ElJoho/BerkikRe-Design/analysis/avl/summary_drag.md

| Model | CD at 12 m/s: profile + winglets + induced + base = total | L/D at 12 m/s | Best L/D (at m/s) | Min. power for level flight [W] |
|---|---|---|---|---|
| Base | 0.0128 + 0.0004 + 0.0048 + 0.0020 = **0.0201** | 10.9 | 14.7 (8) | 3.7 |
| CW | 0.0121 + 0.0003 + 0.0048 + 0.0020 = **0.0192** | 11.3 | 14.8 (8) | 3.7 |
| CC | 0.0126 + 0.0004 + 0.0040 + 0.0020 = **0.0189** | 11.3 | 14.9 (8) | 3.7 |
| CC+CW | 0.0126 + 0.0003 + 0.0039 + 0.0020 = **0.0189** | 11.3 | 15.0 (8) | 3.7 |
| CC+RT | 0.0126 + 0.0004 + 0.0040 + 0.0007 = **0.0177** | 12.1 | 15.5 (8) | 3.5 |
| CC+RT+CW | 0.0126 + 0.0003 + 0.0040 + 0.0007 = **0.0177** | 12.1 | 15.6 (8) | 3.5 |
| RT | 0.0124 + 0.0004 + 0.0048 + 0.0007 = **0.0184** | 11.9 | 15.4 (8) | 3.6 |
| RT+CW | 0.0118 + 0.0003 + 0.0048 + 0.0007 = **0.0176** | 12.4 | 15.6 (8) | 3.5 |
| contourn | 0.0124 + 0.0005 + 0.0049 + 0.0021 = **0.0198** | 10.9 | 14.9 (8) | 3.7 |

Strip cl outside a polar's range (clamped): {'Base': 0, 'CW': 54, 'CC': 36, 'CC+CW': 36, 'CC+RT': 36, 'CC+RT+CW': 16, 'RT': 108, 'RT+CW': 96, 'contourn': 568}
