ElJoho/BerkikRe-Design/analysis/figures/views_front.png

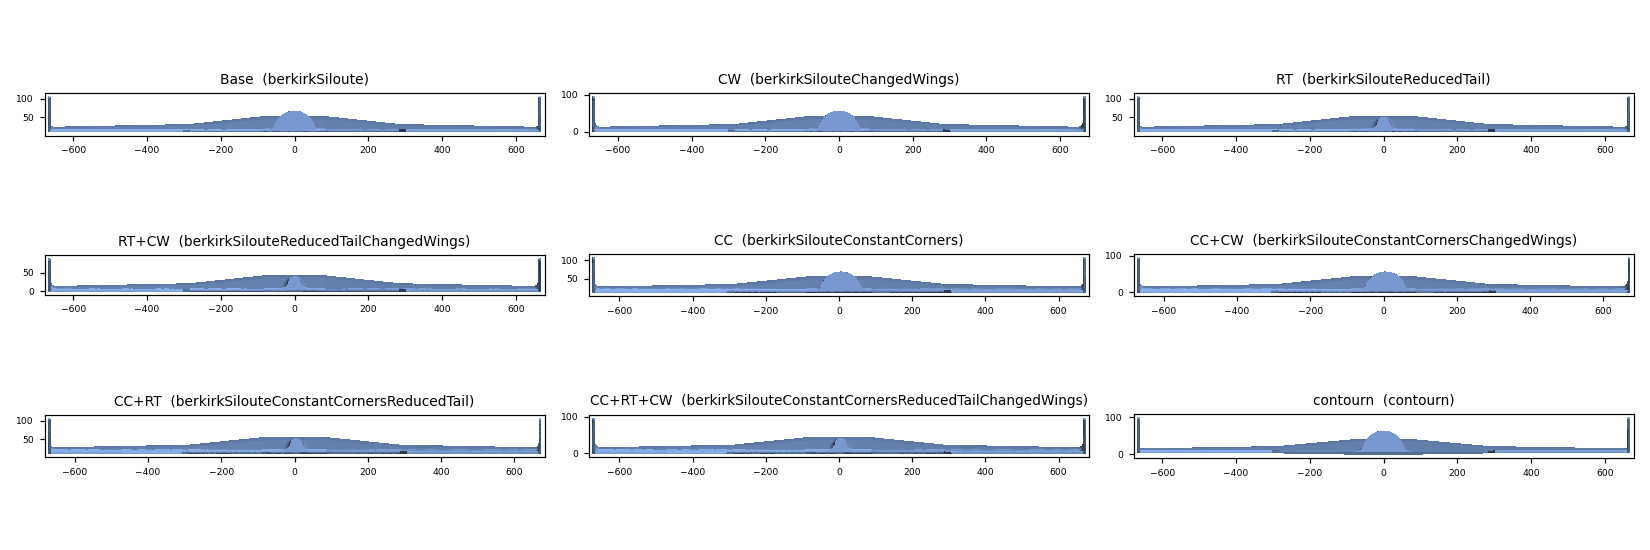
analysis/figures/views_front.png
