ElJoho/BerkikRe-Design/berkik_layout.png

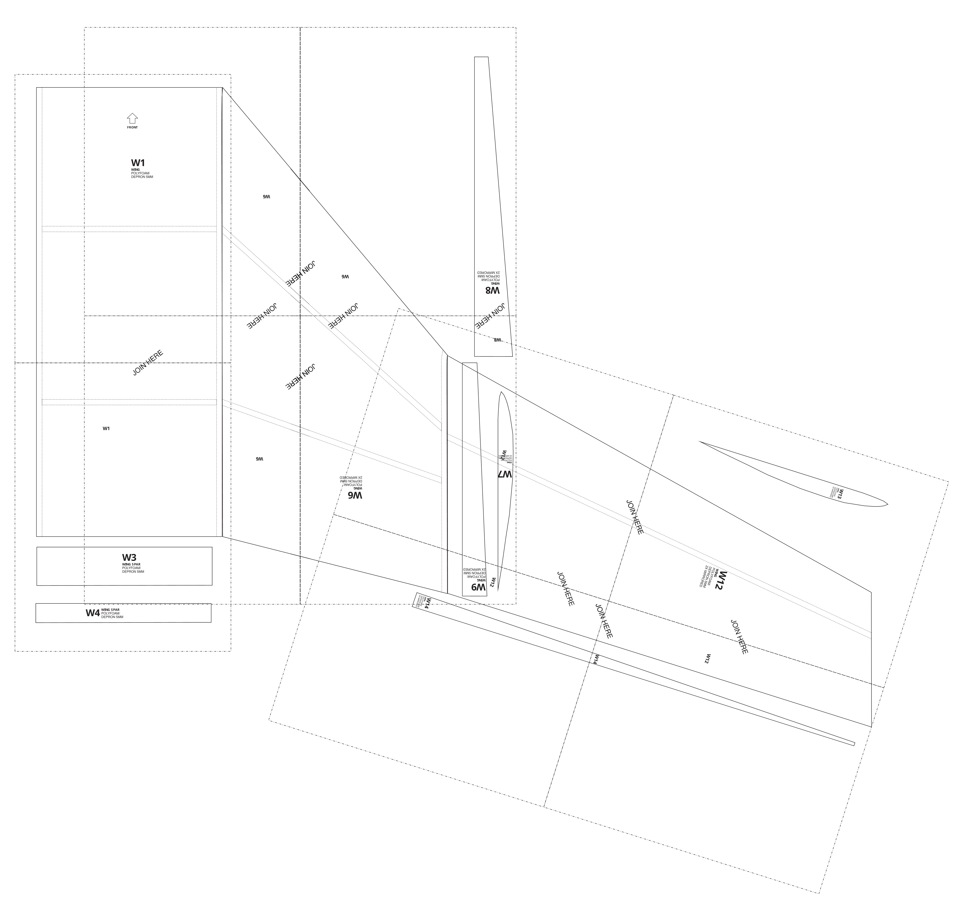
berkik_layout.png
