ElJoho/BerkikRe-Design/berkik_w2_w5_m1_m2_m3.png

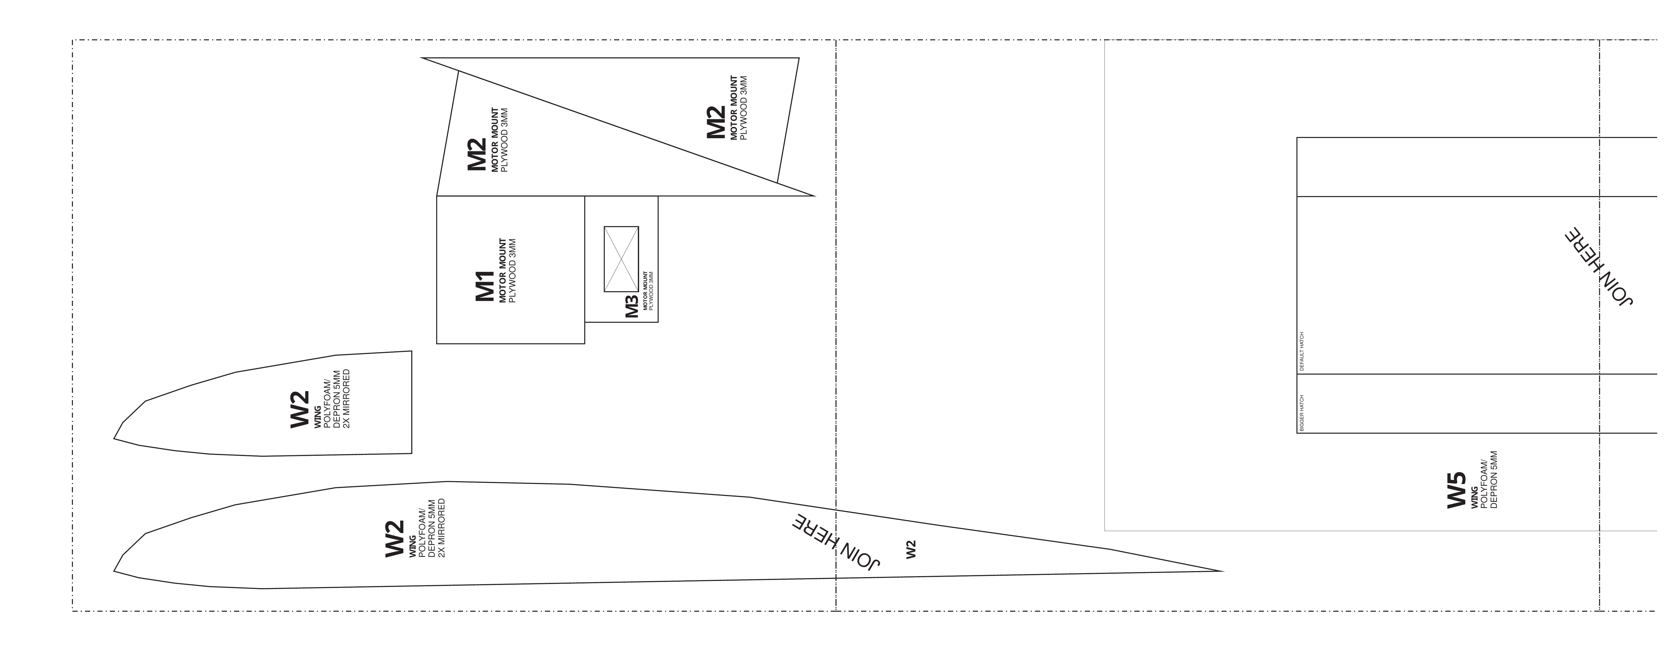
berkik_w2_w5_m1_m2_m3.png
