ElJoho/BerkikRe-Design/img/berkik_w15_w16_w17_w18_t1.png

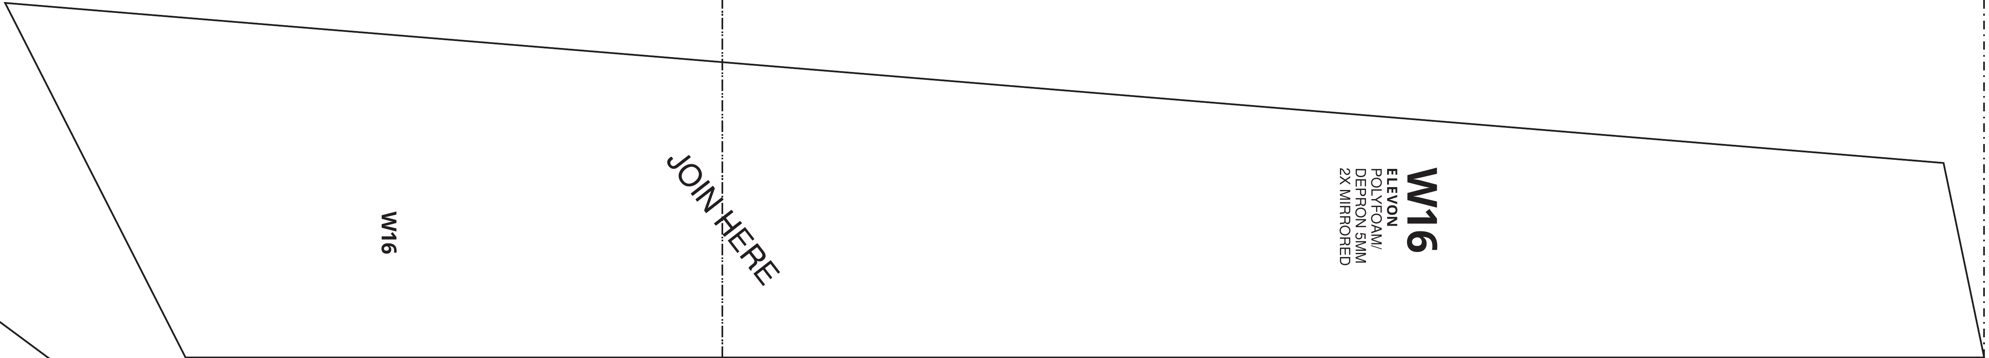
img/berkik_w15_w16_w17_w18_t1.png
