ElJoho/BerkikRe-Design/img/M1.png

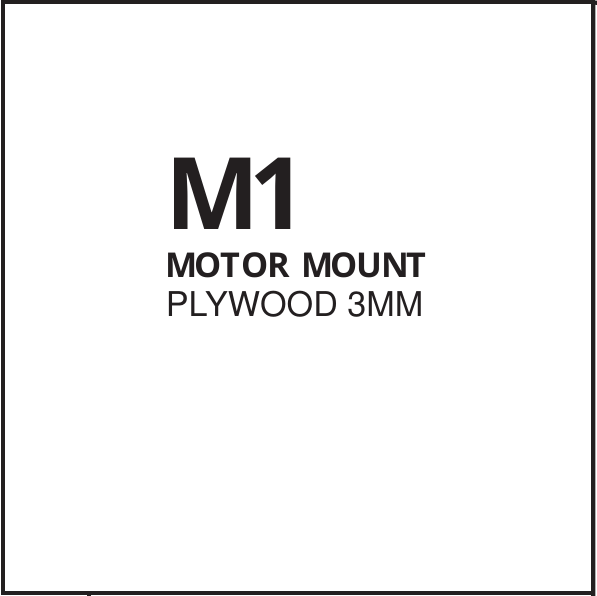
img/M1.png
