ElJoho/BerkikRe-Design/img/pagina-01.png

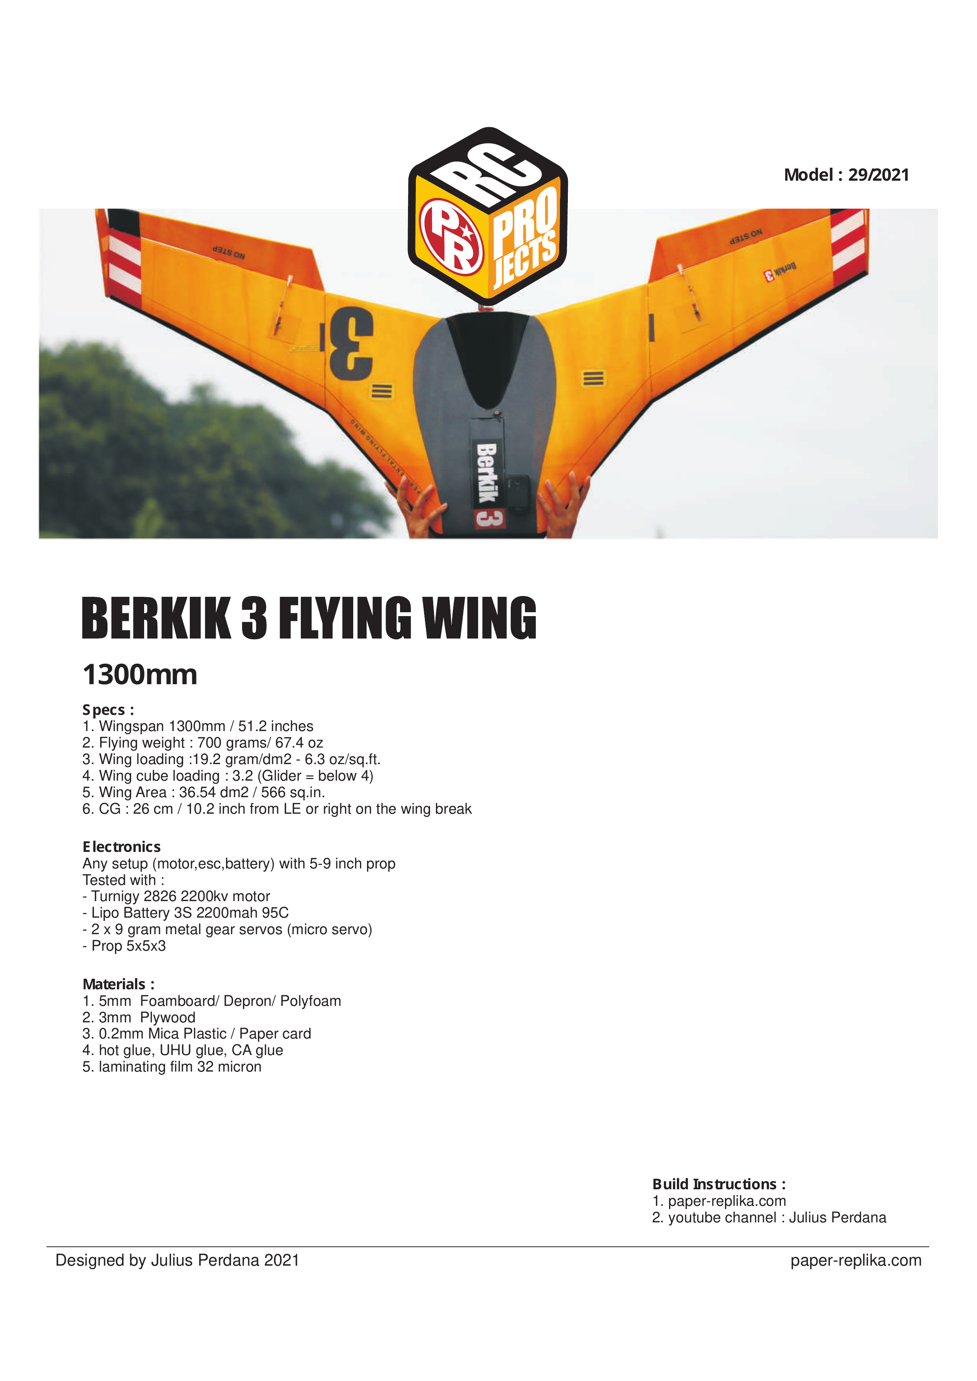
img/pagina-01.png
