ElJoho/BerkikRe-Design/img/pagina-02.png

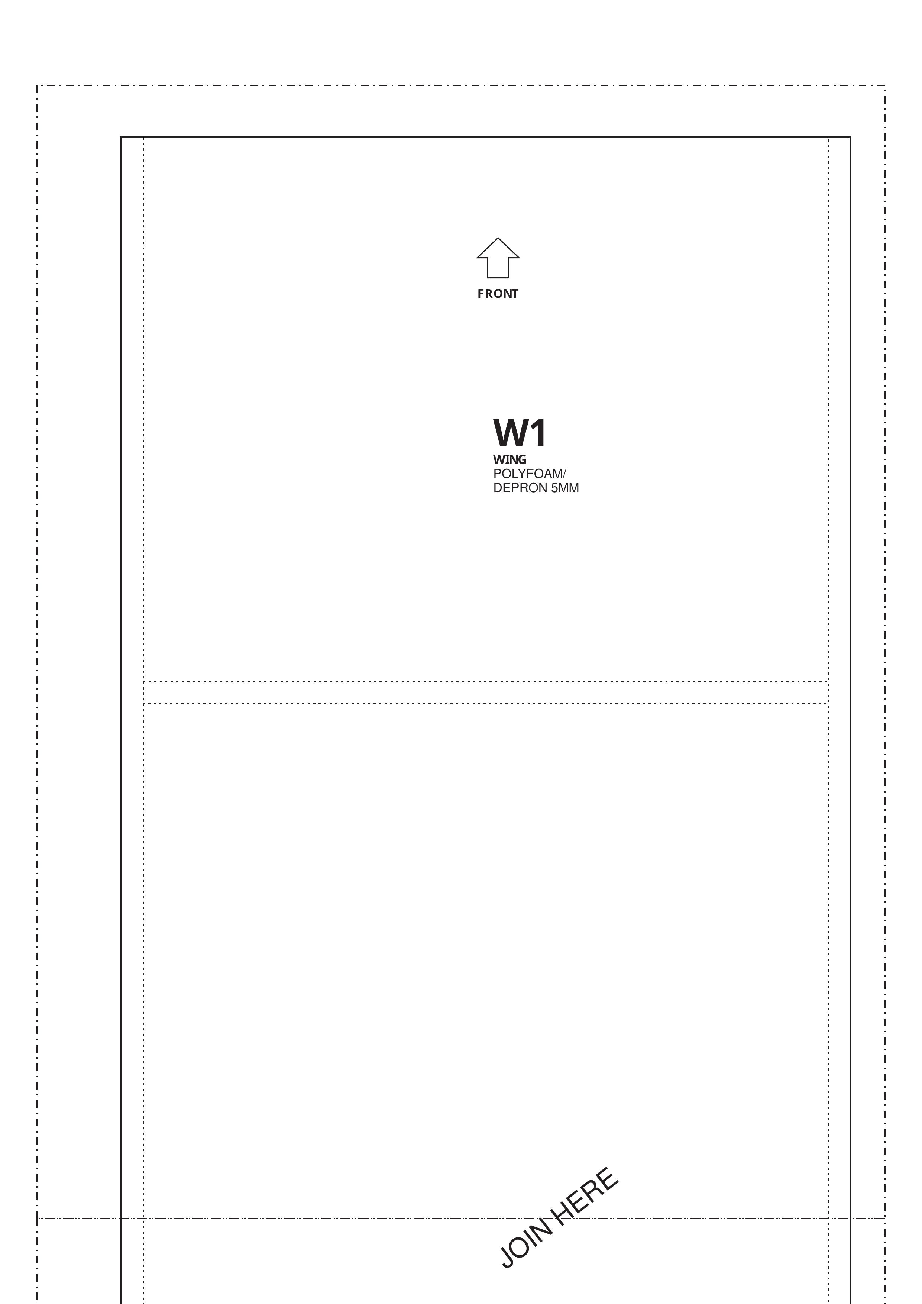
img/pagina-02.png
