ElJoho/BerkikRe-Design/img/pagina-03.png

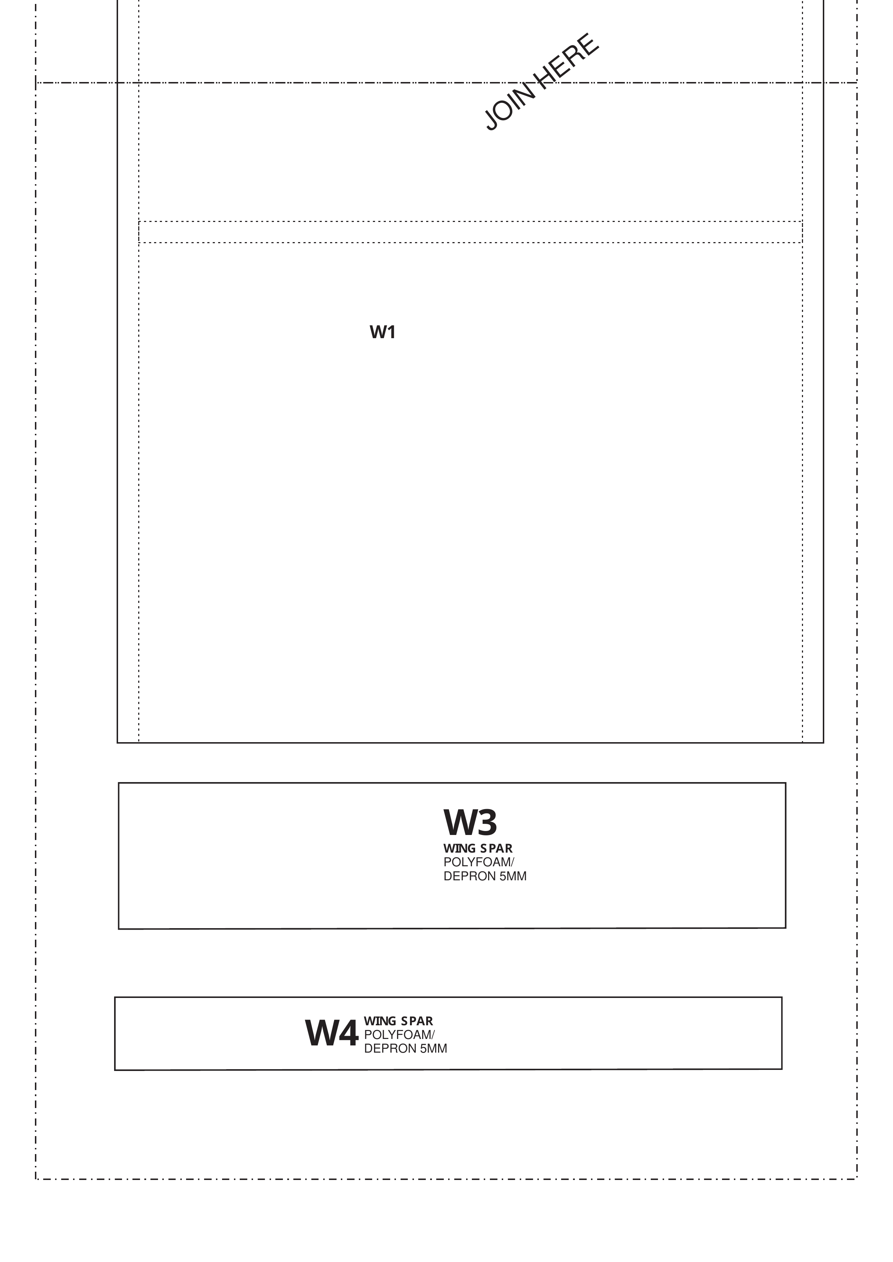
img/pagina-03.png
