ElJoho/BerkikRe-Design/img/pagina-04.png

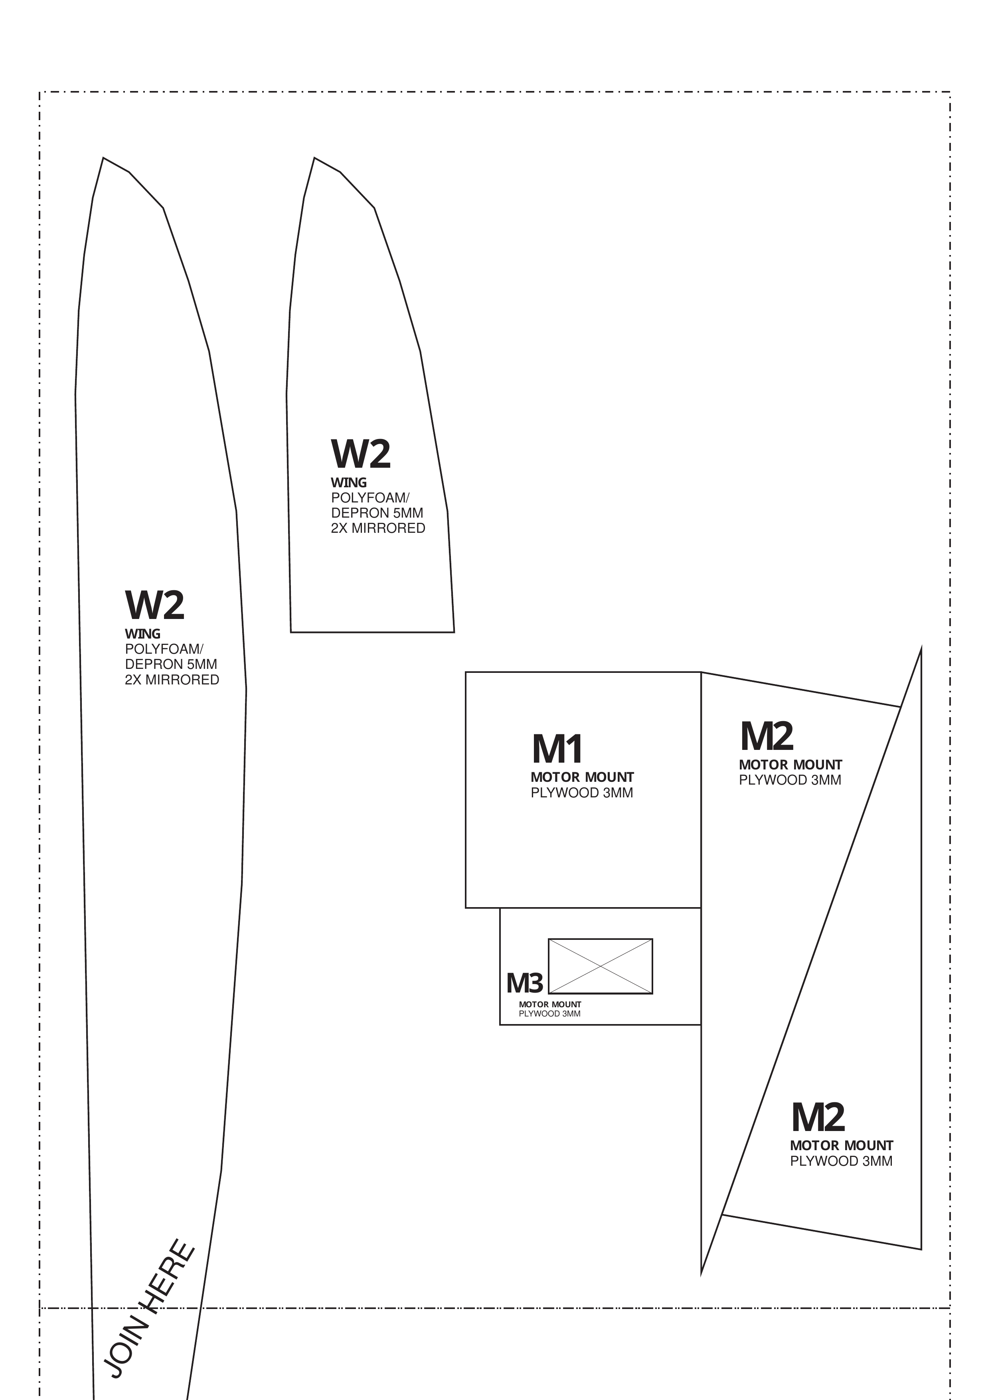
img/pagina-04.png
