ElJoho/BerkikRe-Design/img/pagina-05.png

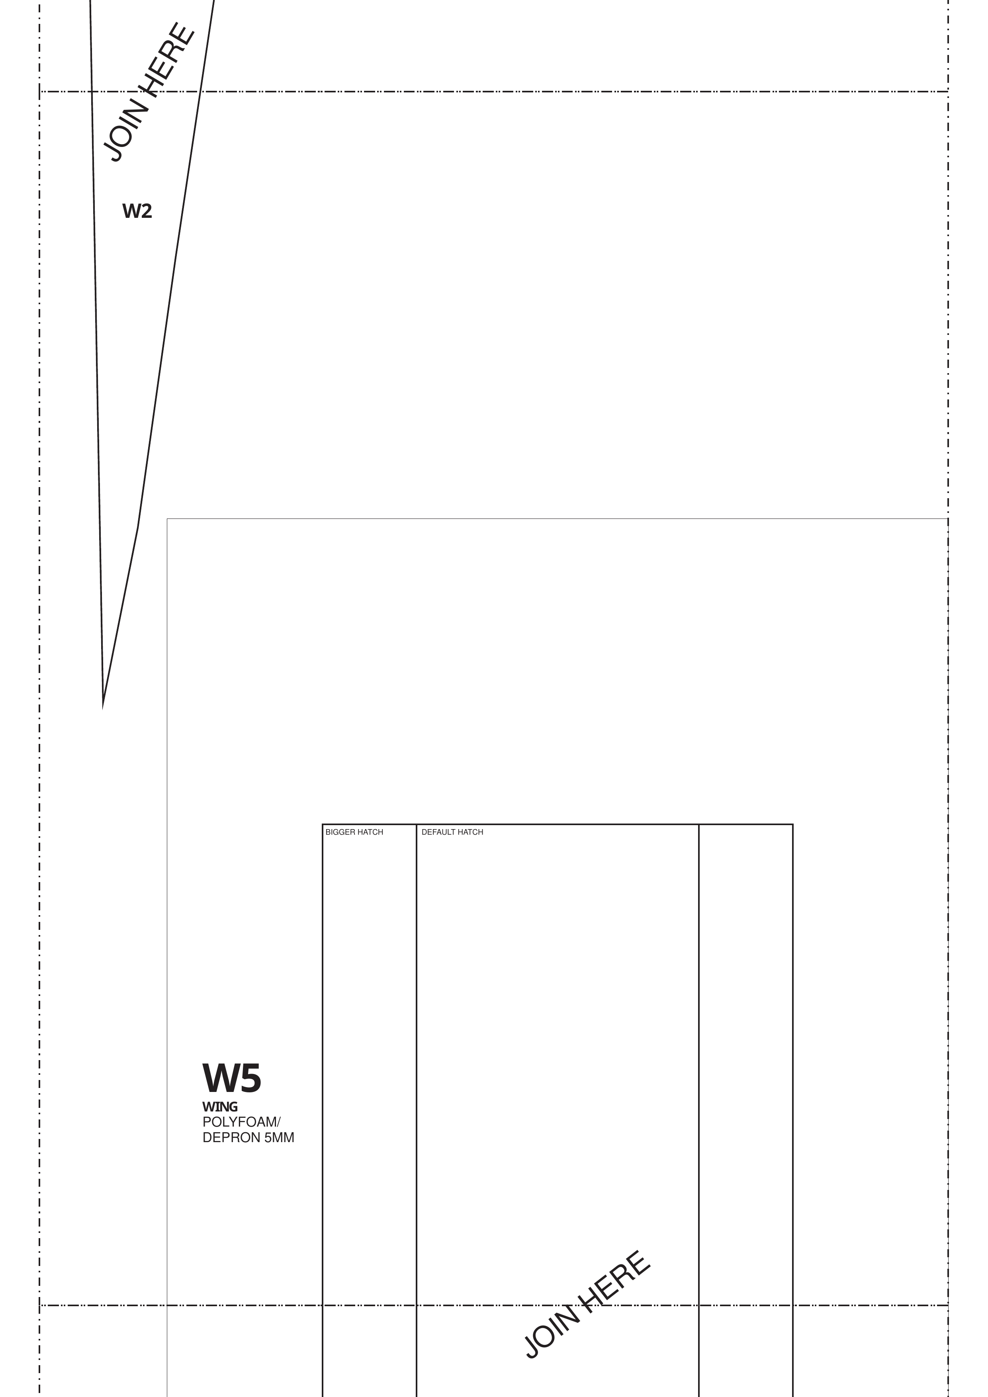
img/pagina-05.png
