ElJoho/BerkikRe-Design/img/pagina-06.png

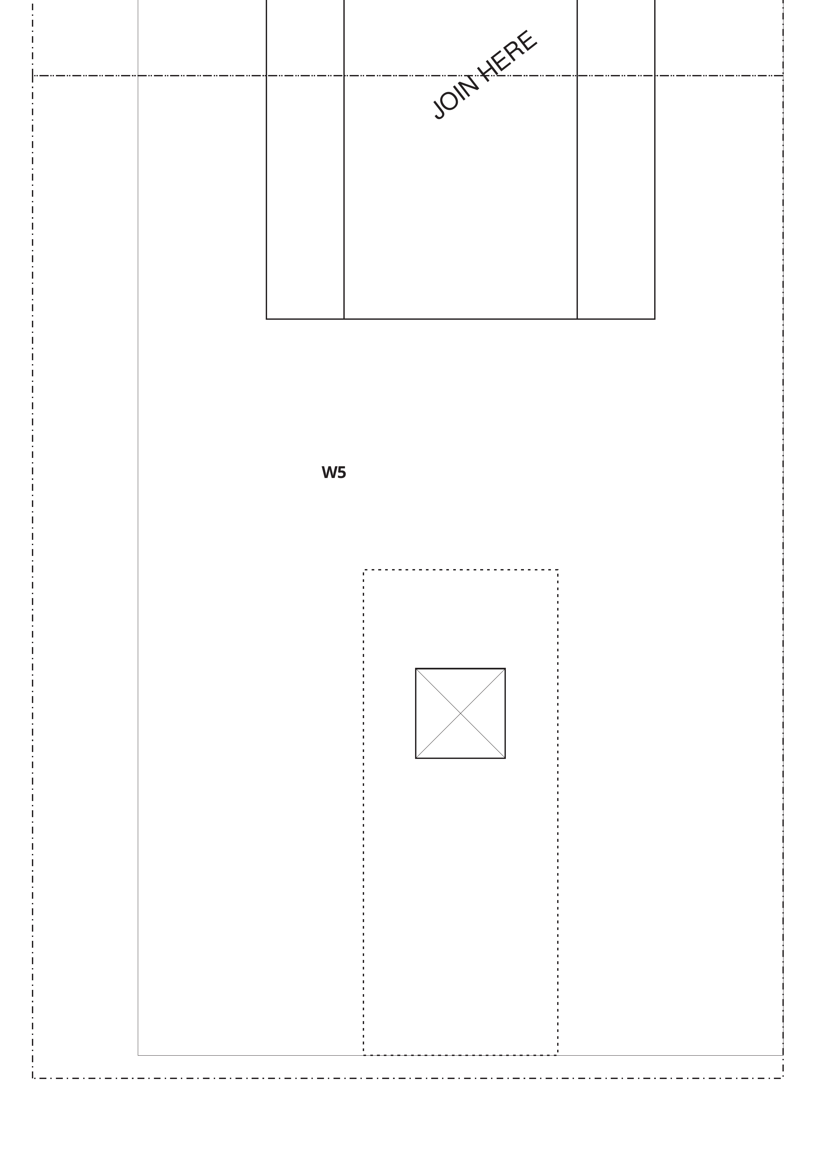
img/pagina-06.png
