ElJoho/BerkikRe-Design/img/pagina-07.png

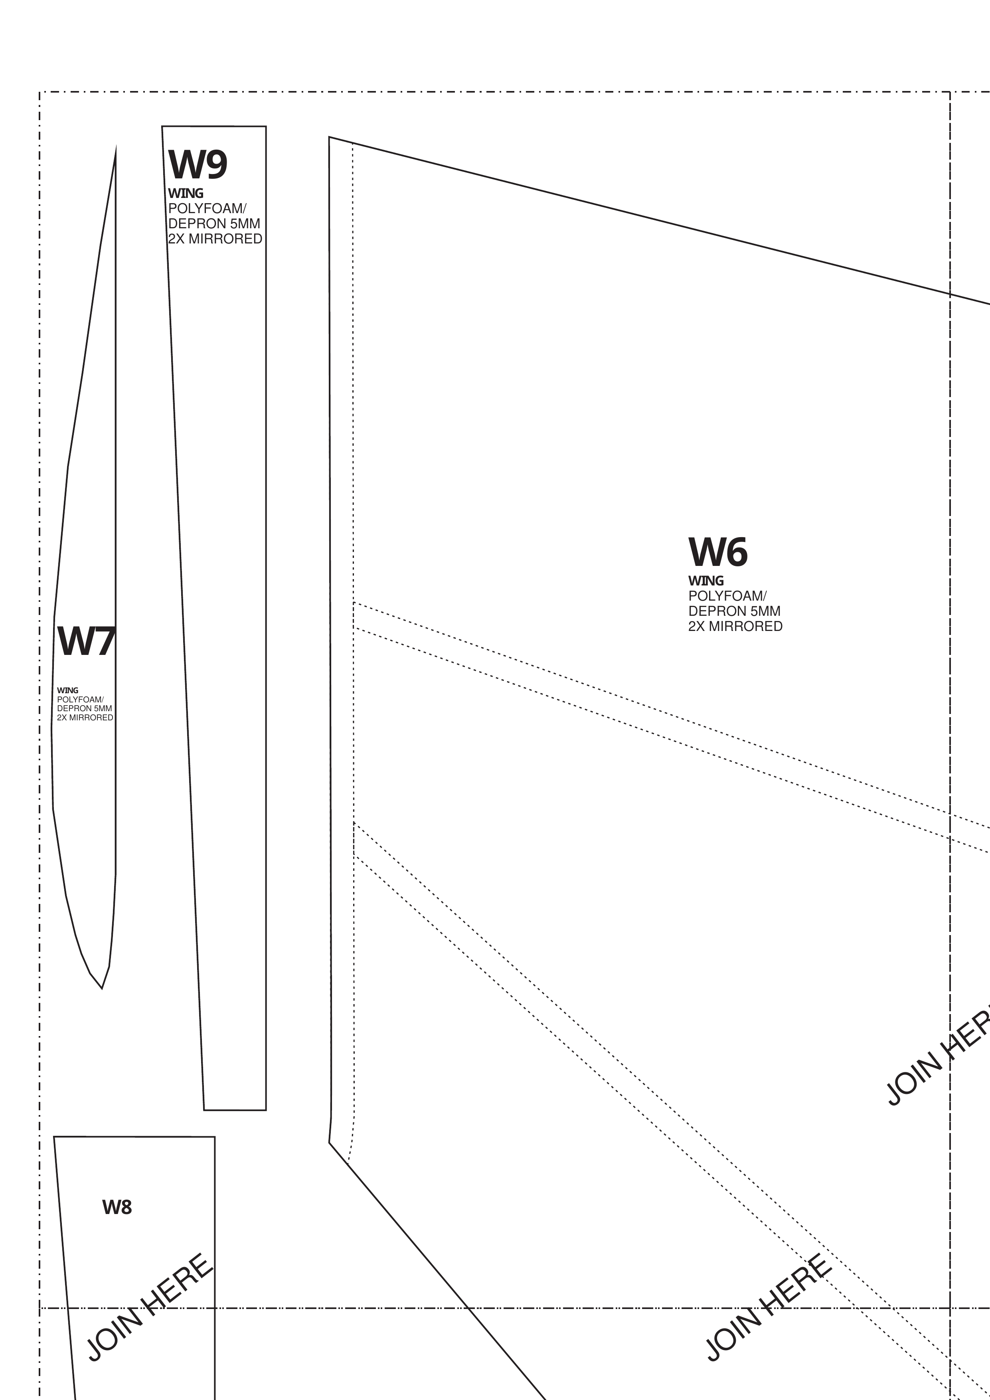
img/pagina-07.png
