ElJoho/BerkikRe-Design/img/pagina-08.png

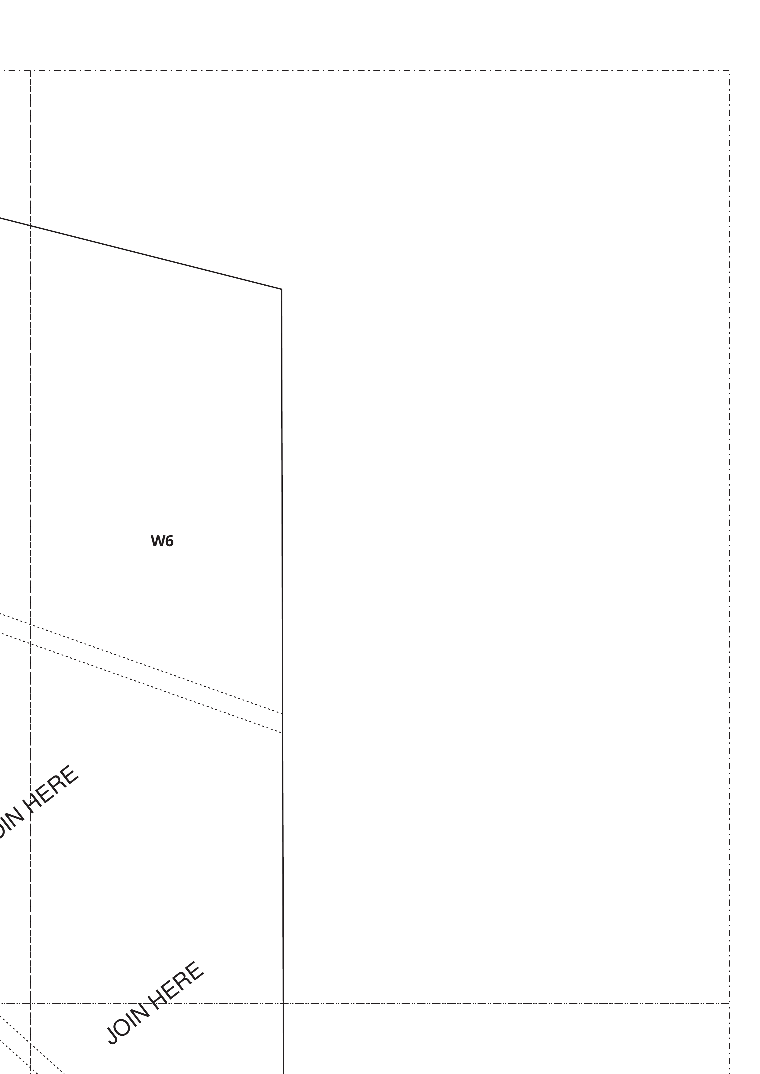
img/pagina-08.png
