ElJoho/BerkikRe-Design/img/pagina-09.png

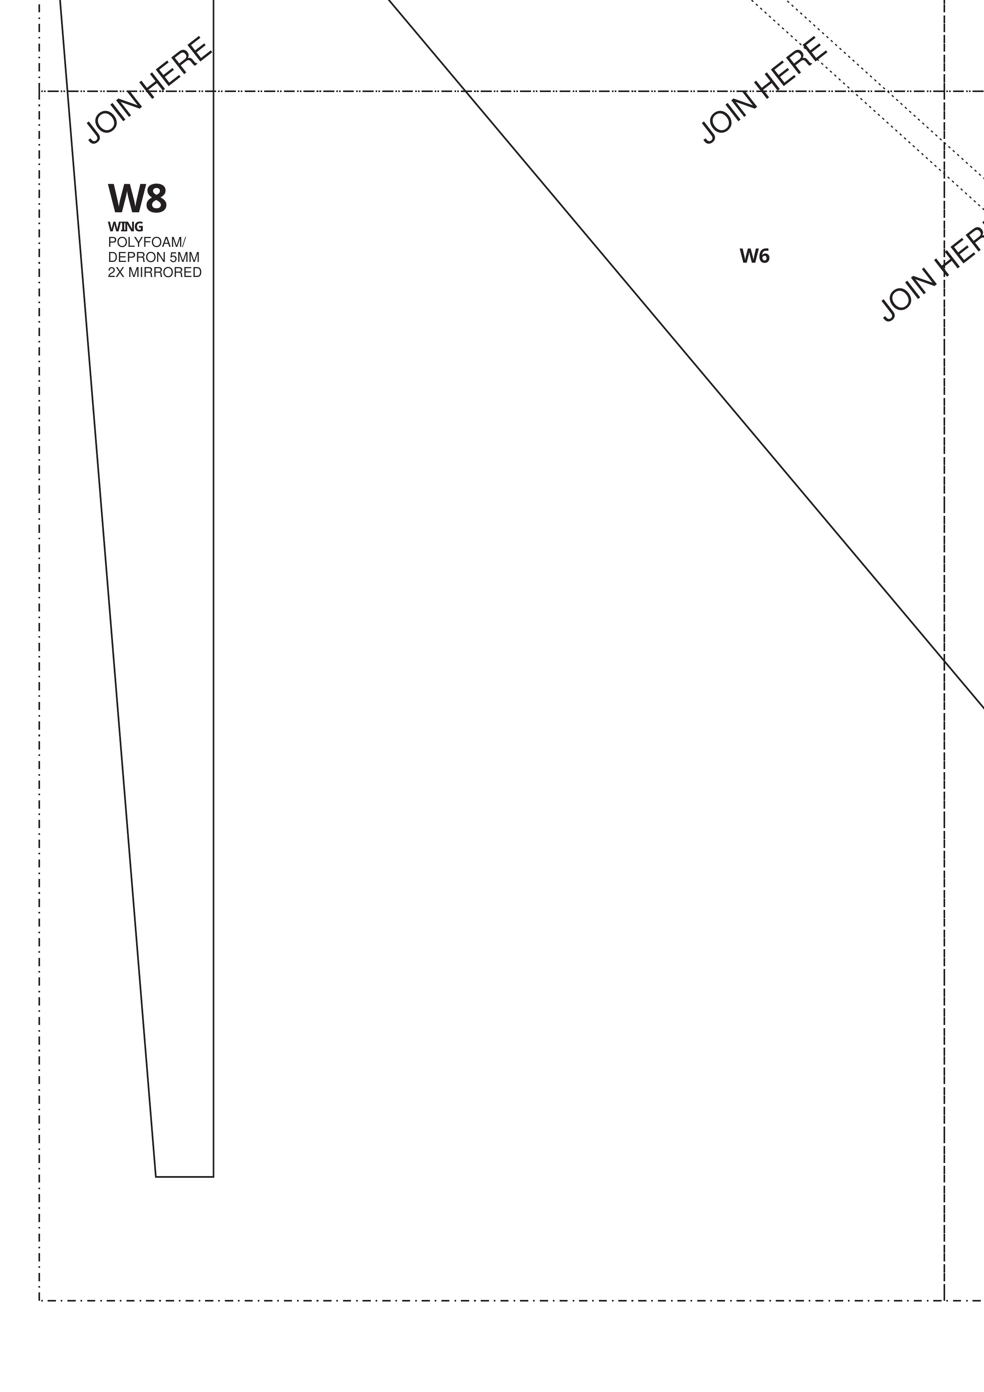
img/pagina-09.png
