ElJoho/BerkikRe-Design/img/pagina-10.png

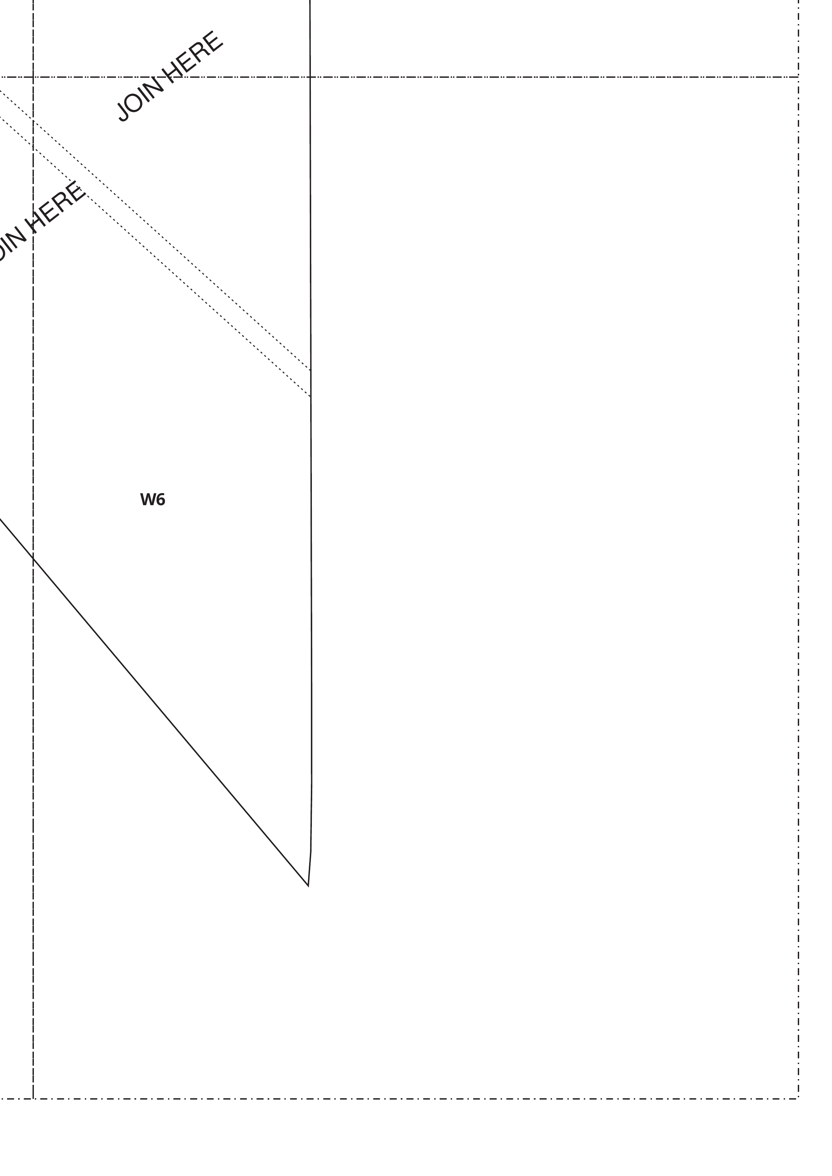
img/pagina-10.png
