ElJoho/BerkikRe-Design/img/pagina-11.png

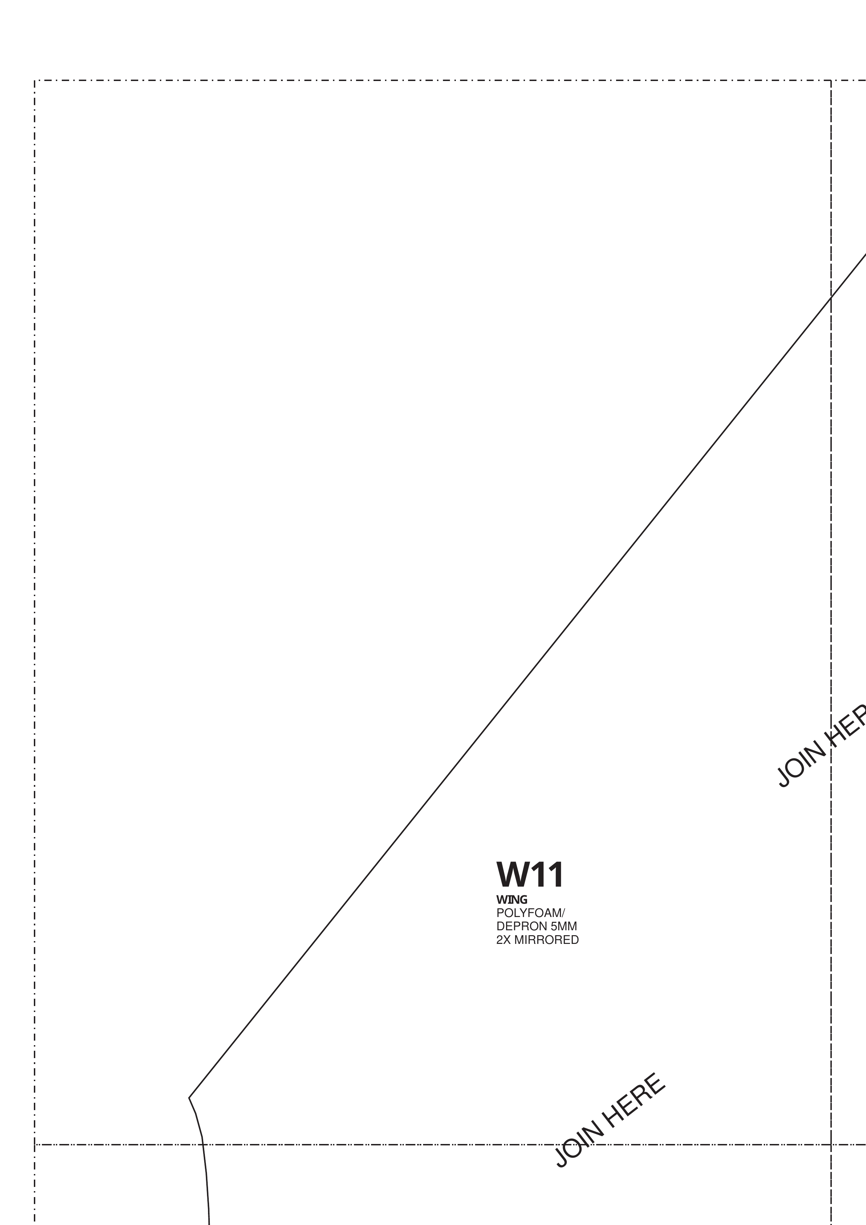
img/pagina-11.png
