ElJoho/BerkikRe-Design/img/pagina-12.png

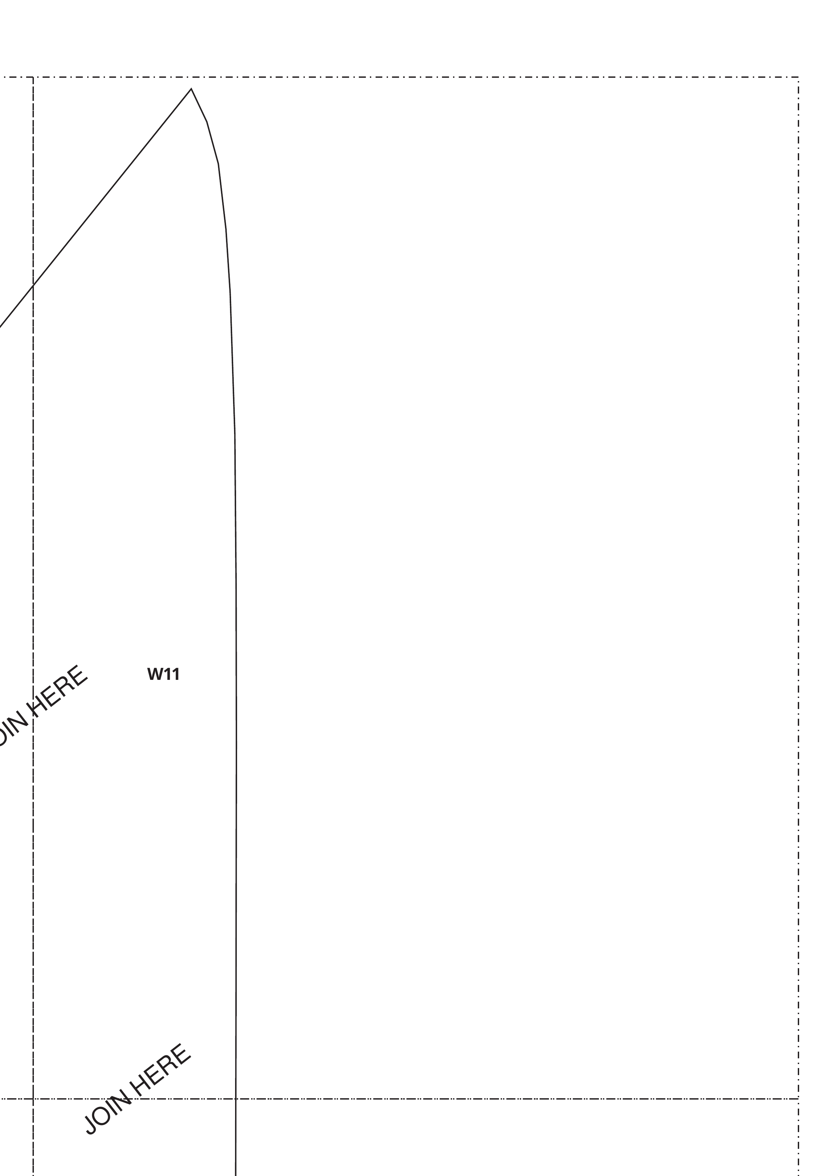
img/pagina-12.png
