ElJoho/BerkikRe-Design/img/pagina-13.png

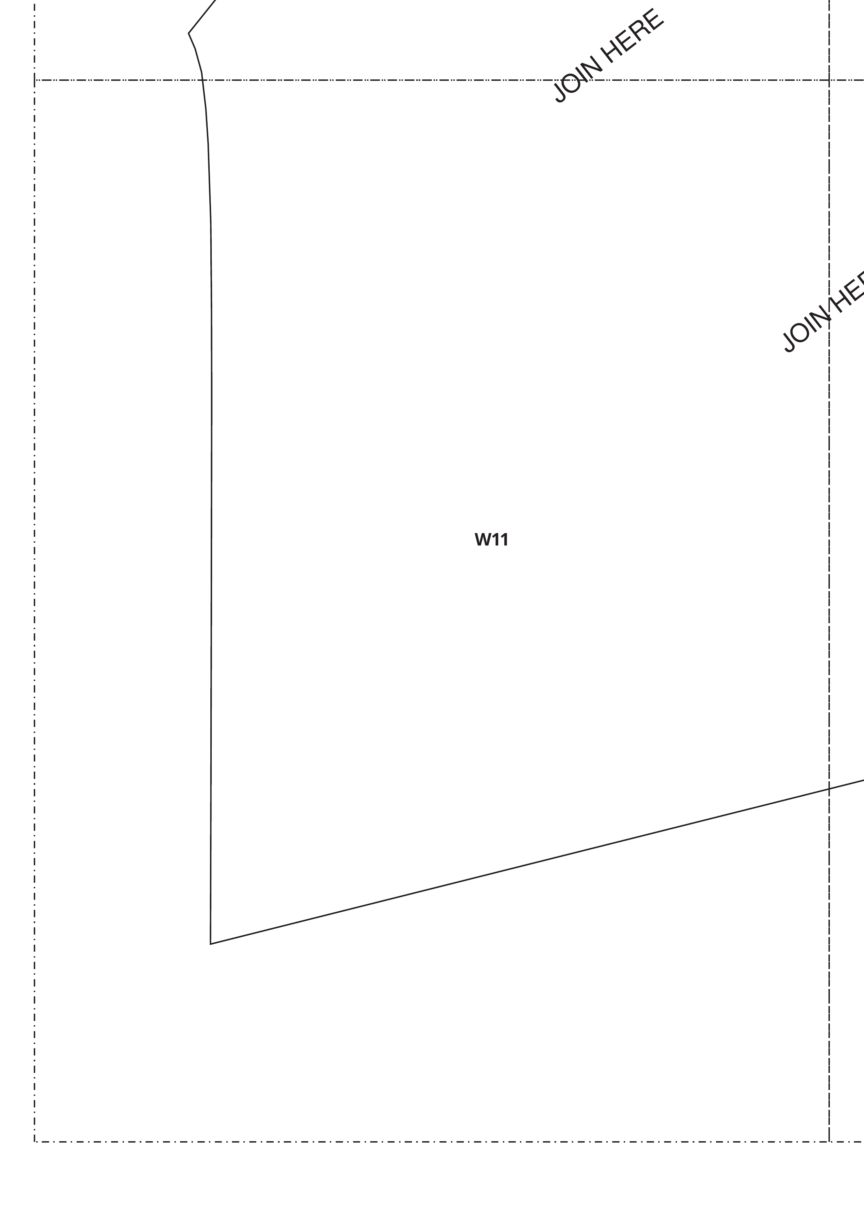
img/pagina-13.png
