ElJoho/BerkikRe-Design/img/pagina-14.png

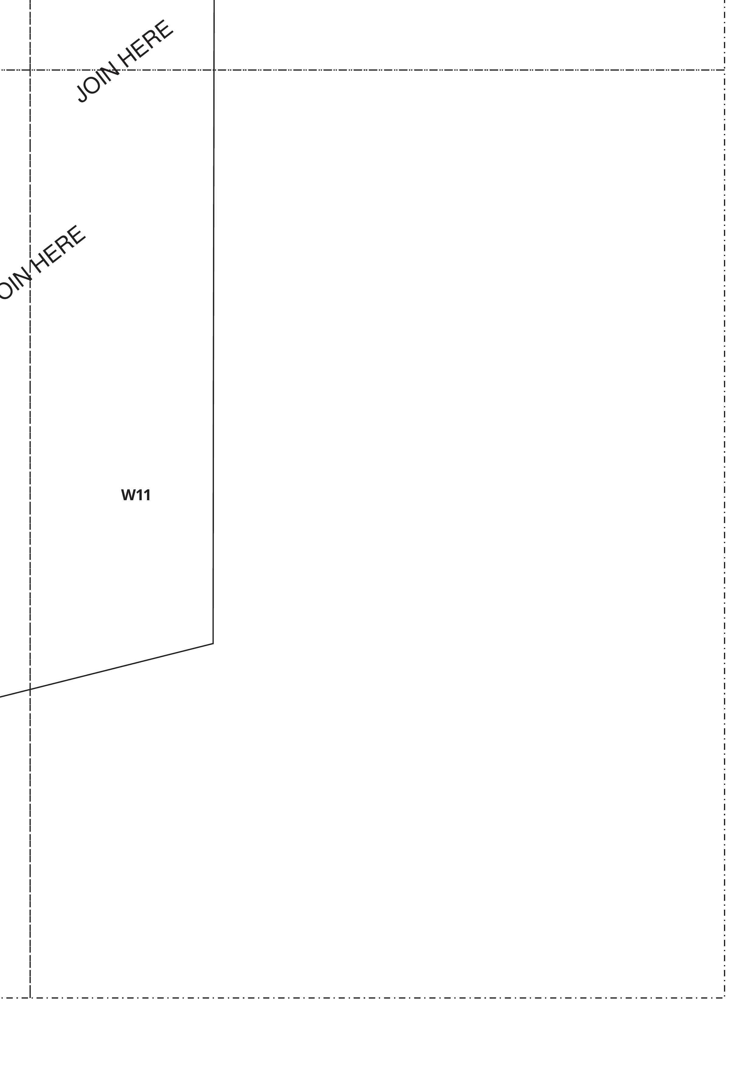
img/pagina-14.png
