ElJoho/BerkikRe-Design/img/pagina-15.png

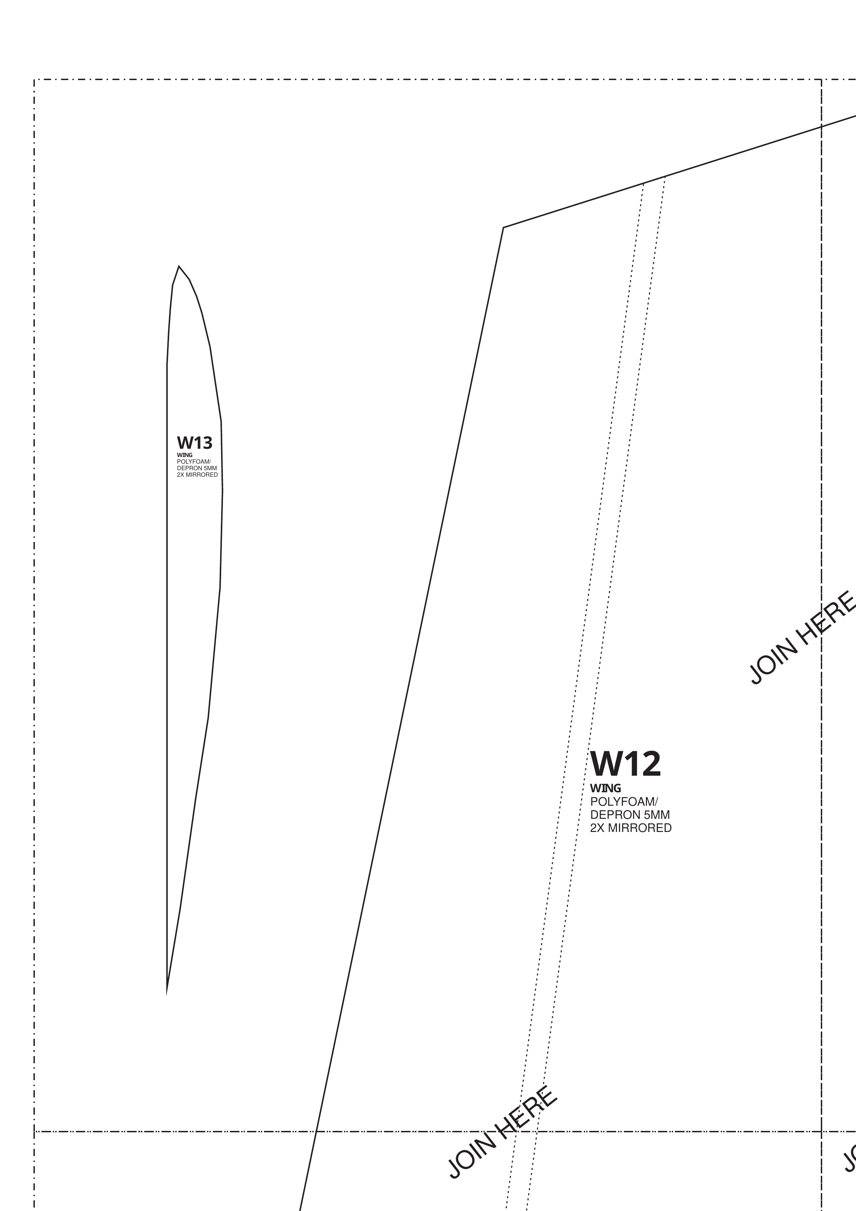
img/pagina-15.png
