ElJoho/BerkikRe-Design/img/pagina-16.png

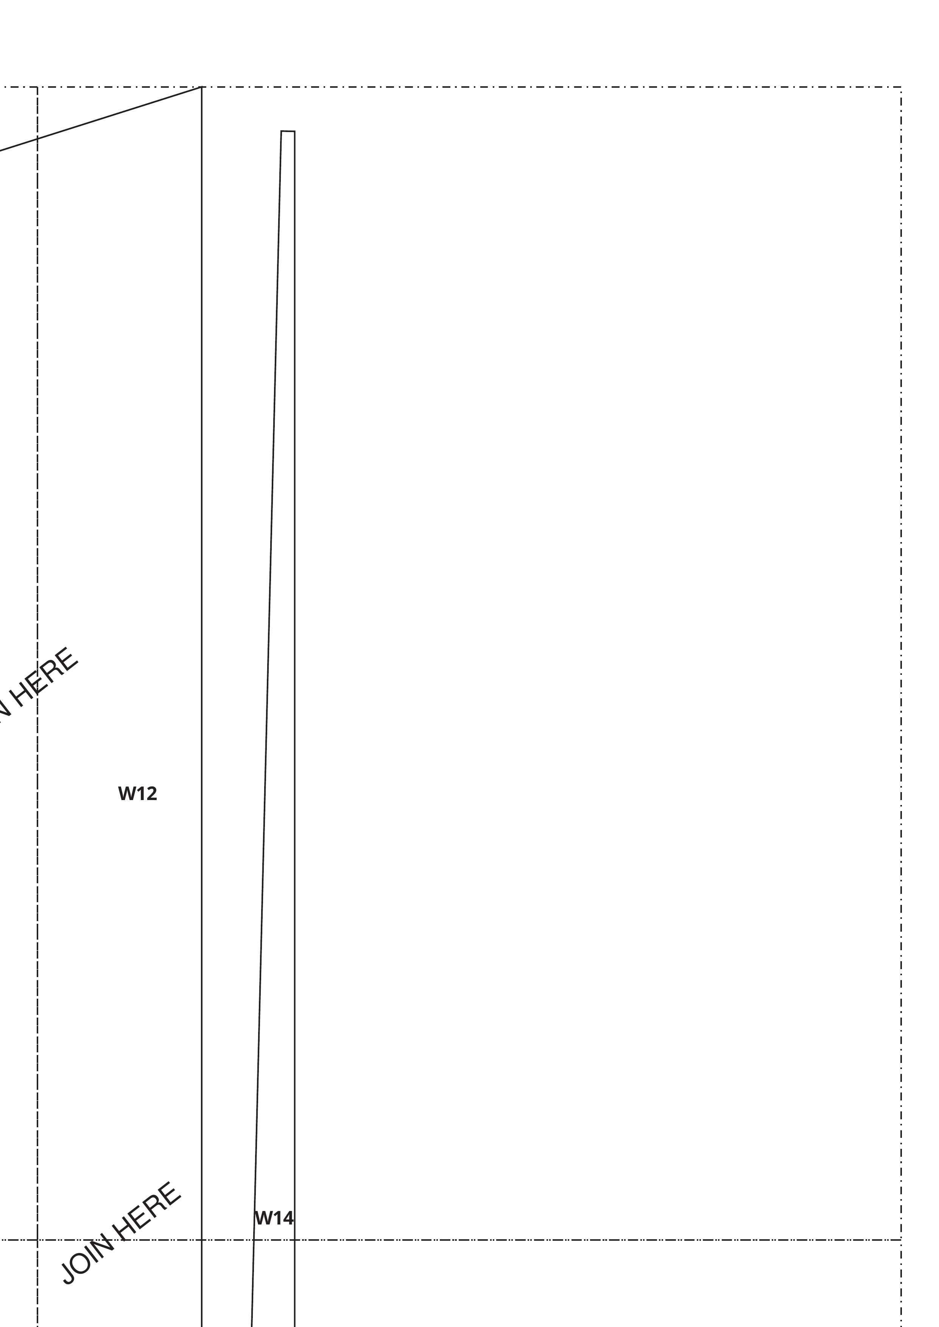
img/pagina-16.png
