ElJoho/BerkikRe-Design/img/pagina-17.png

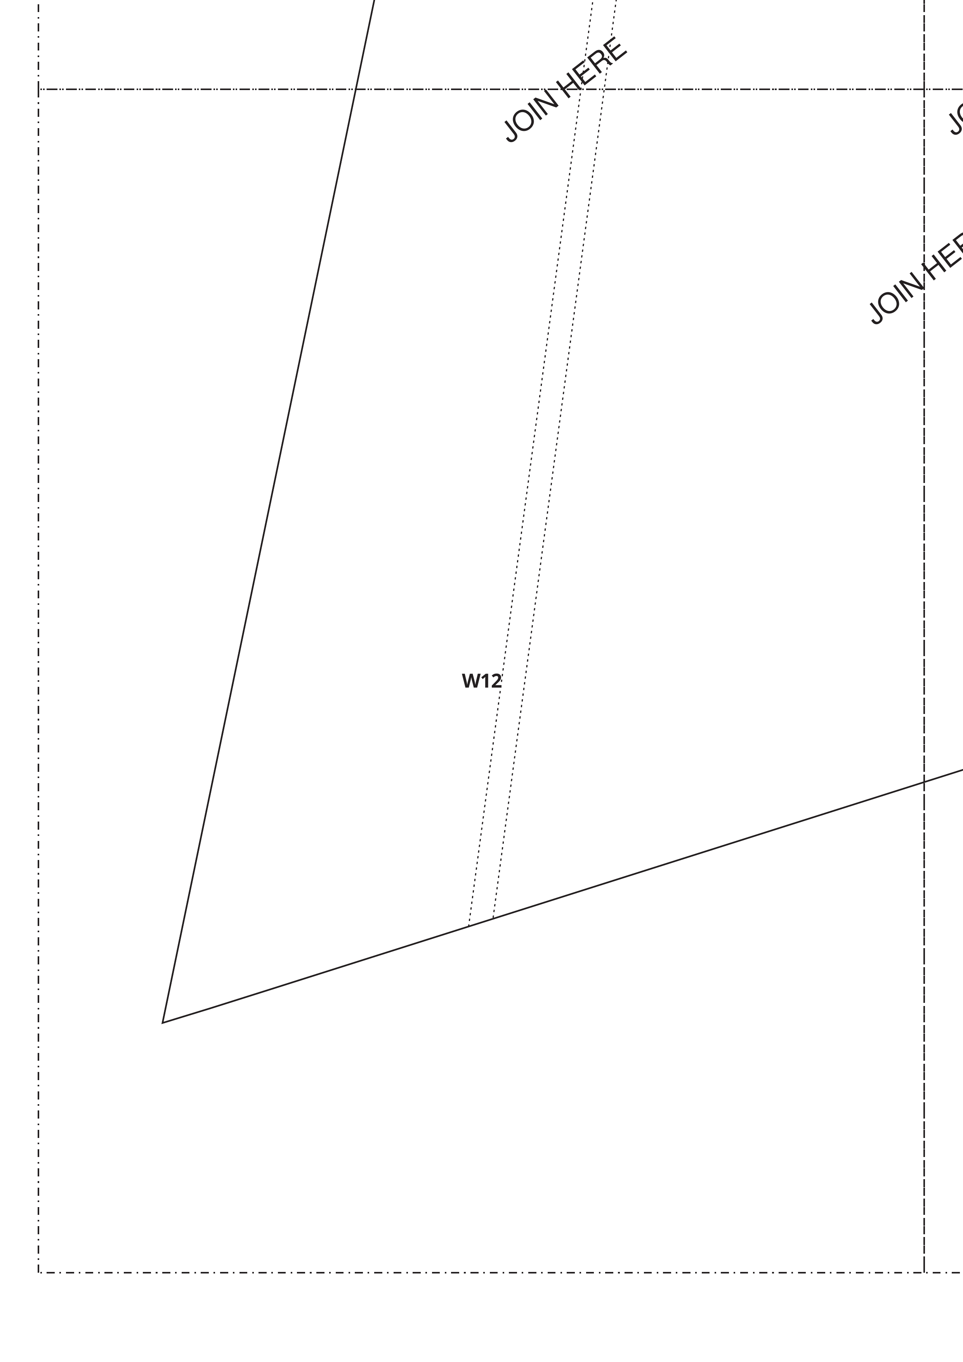
img/pagina-17.png
