ElJoho/BerkikRe-Design/img/pagina-19.png

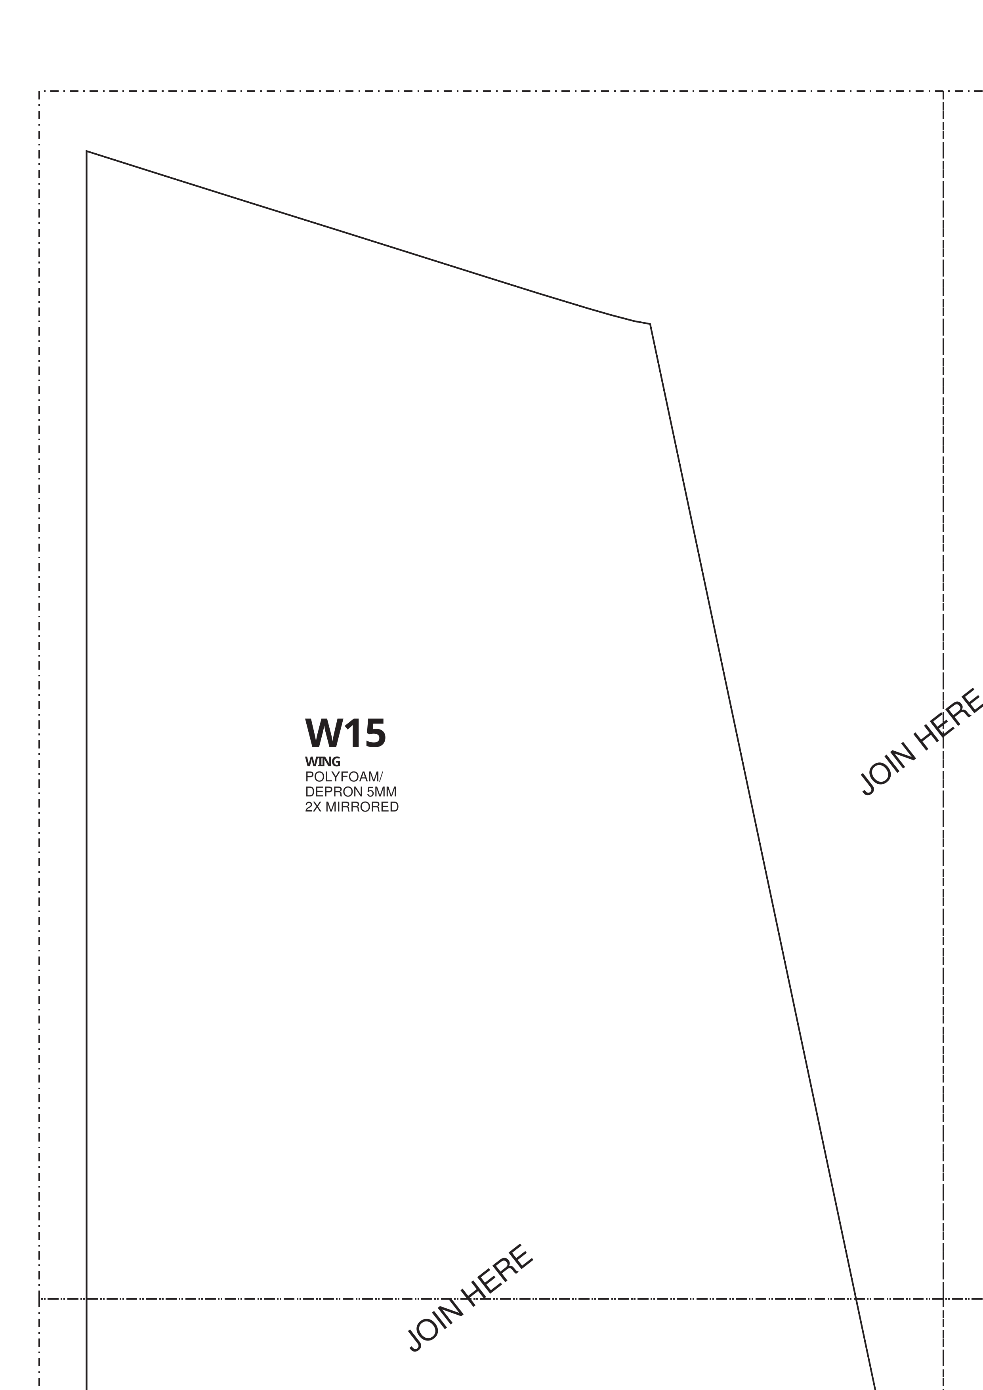
img/pagina-19.png
