ElJoho/BerkikRe-Design/img/pagina-20.png

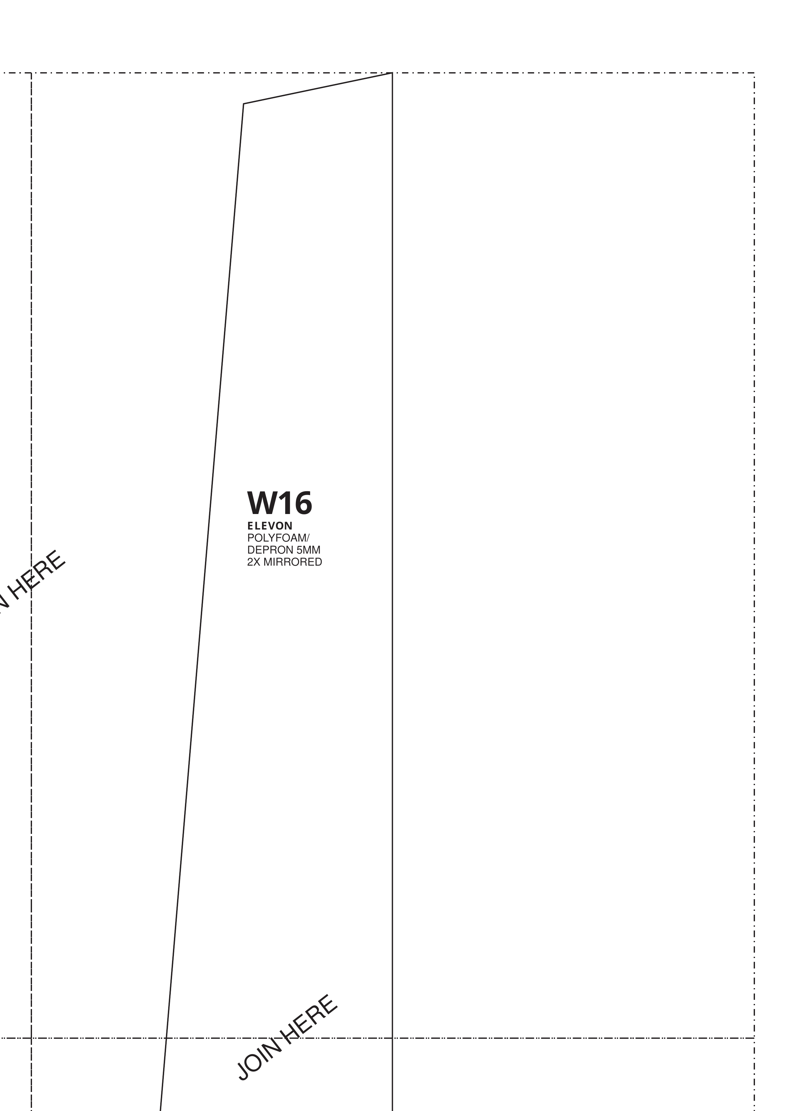
img/pagina-20.png
