ElJoho/BerkikRe-Design/img/pagina-21.png

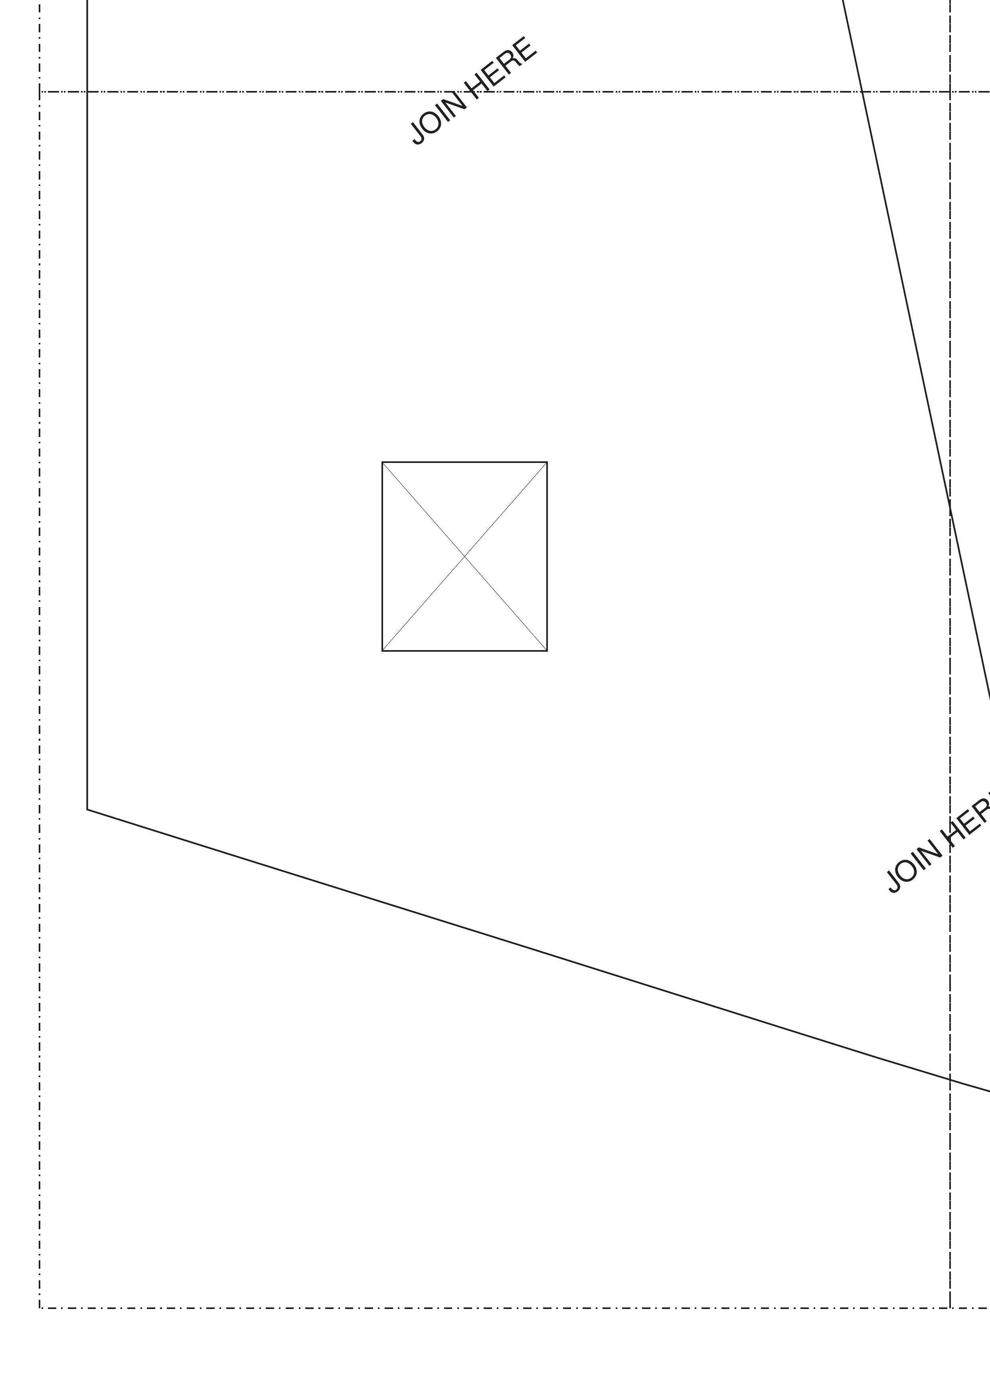
img/pagina-21.png
