ElJoho/BerkikRe-Design/img/pagina-22.png

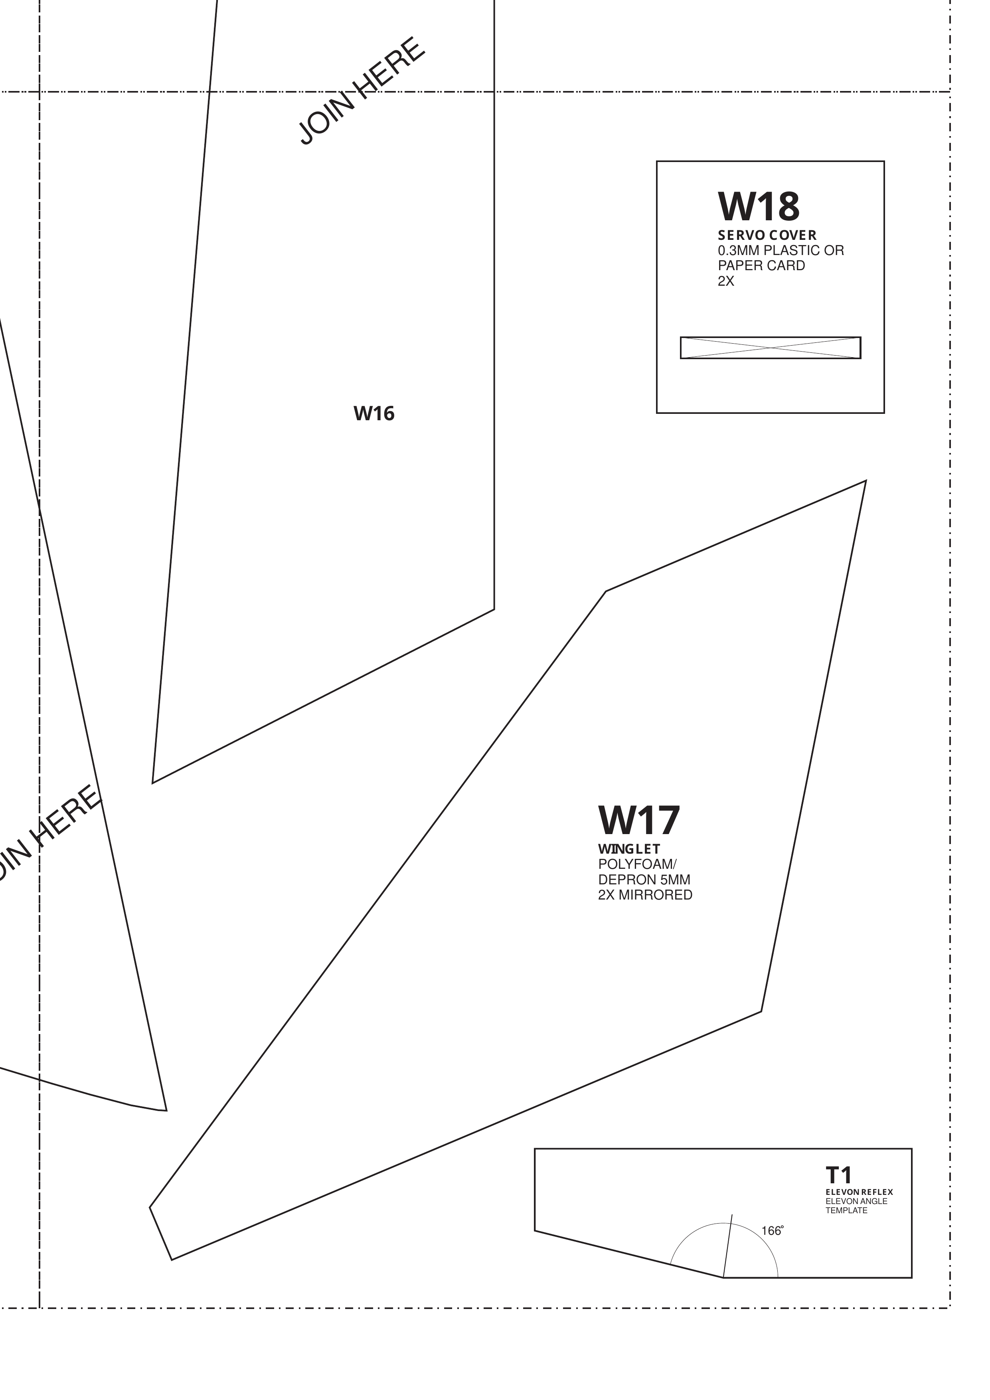
img/pagina-22.png
