ElJoho/BerkikRe-Design/img/pagina-23.png

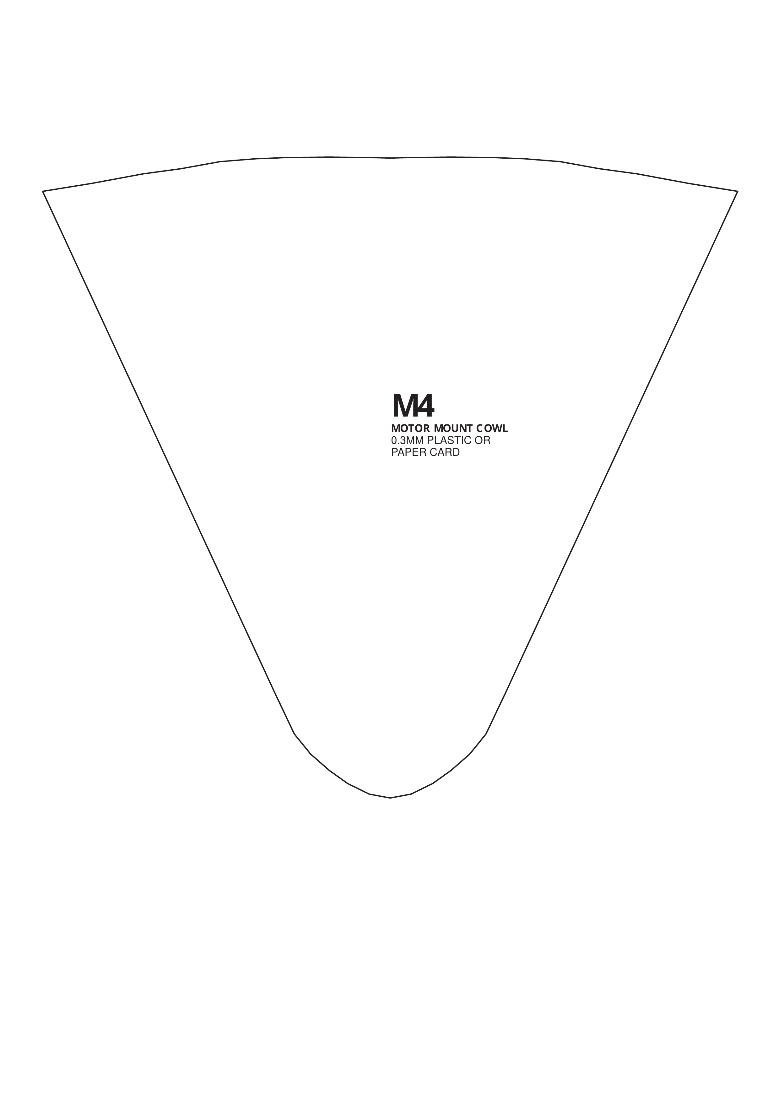
img/pagina-23.png
