ElJoho/BerkikRe-Design/img/w17.png

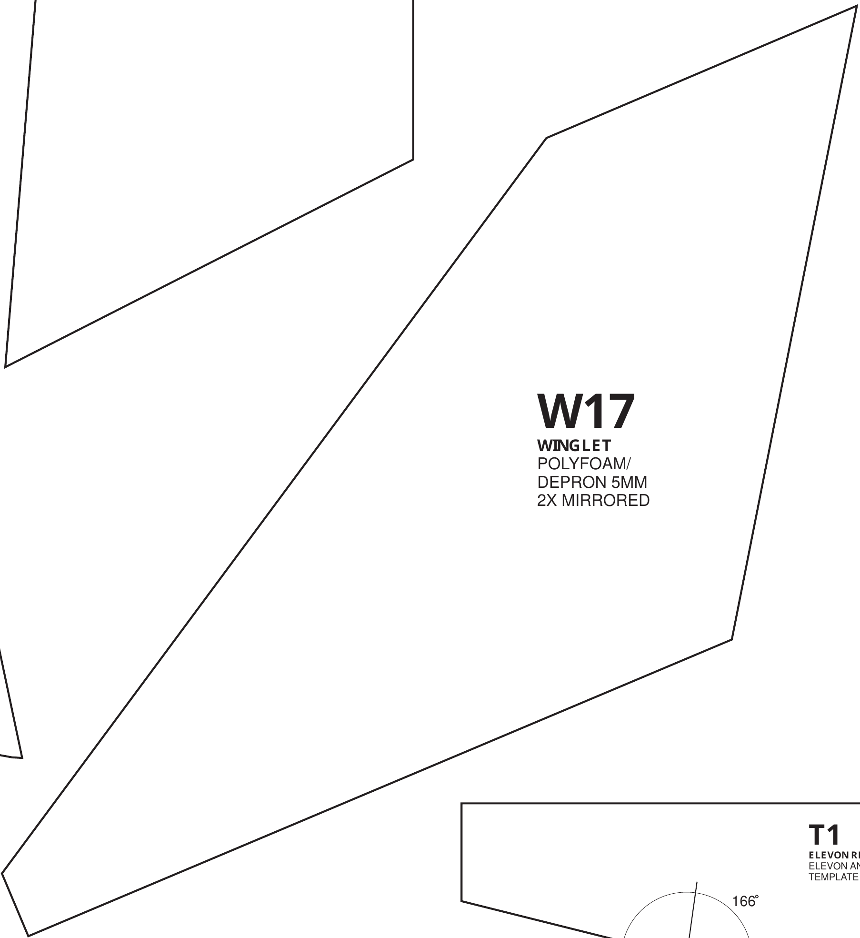
img/w17.png
