ElJoho/BerkikRe-Design/img/W!8.png

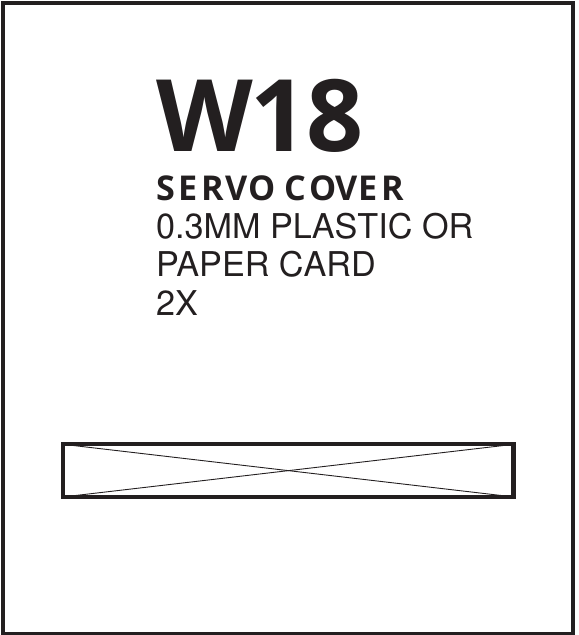
img/W!8.png
