ElJoho/BerkikRe-Design/w2.png

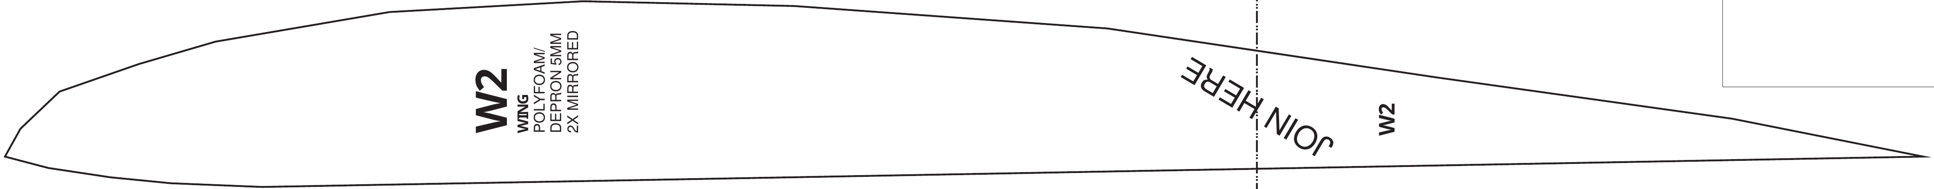
w2.png
