ElJoho/BerkikRe-Design/weights/20261016_164948.jpg

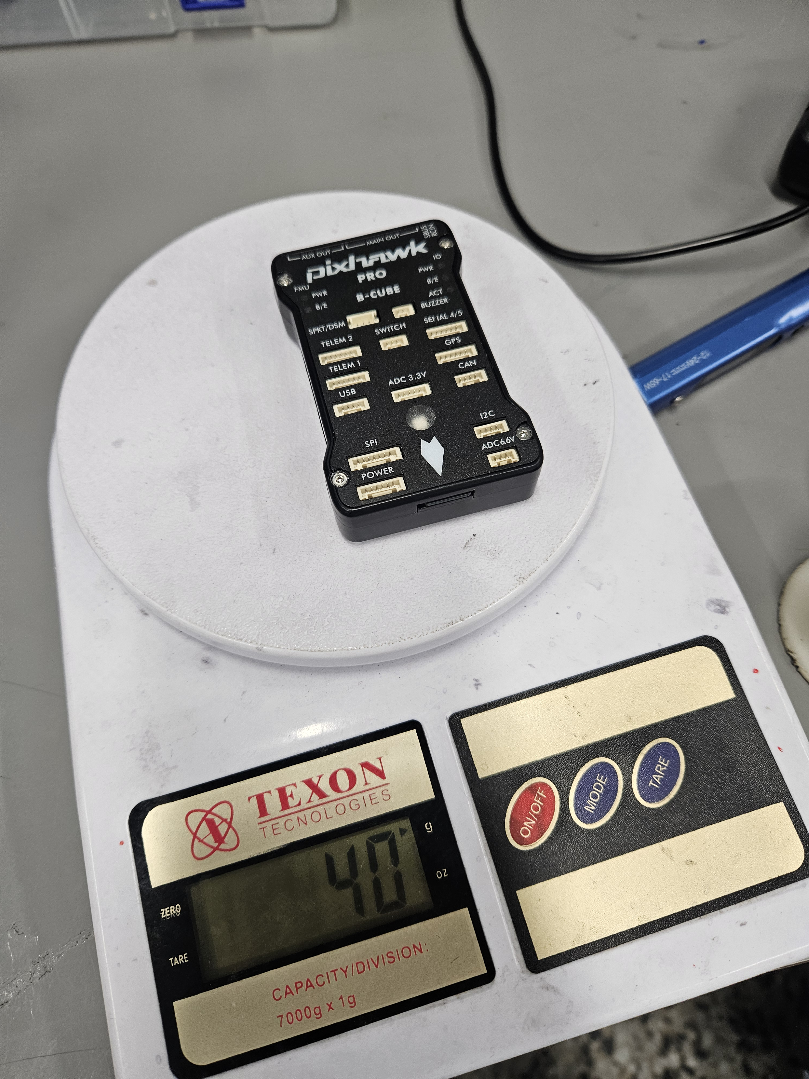
weights/20261016_164948.jpg
