ElJoho/BerkikRe-Design/weights/20261016_164949.jpg

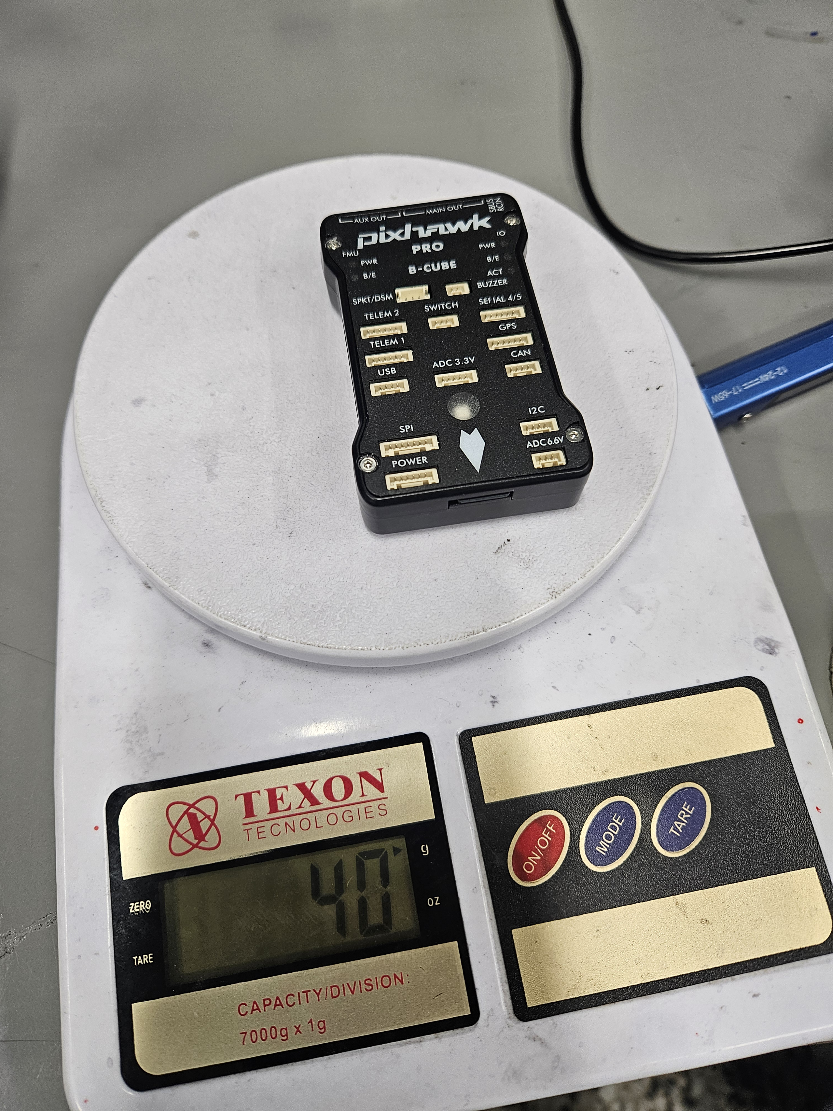
weights/20261016_164949.jpg
