ElJoho/BerkikRe-Design/weights/20261016_172121.jpg

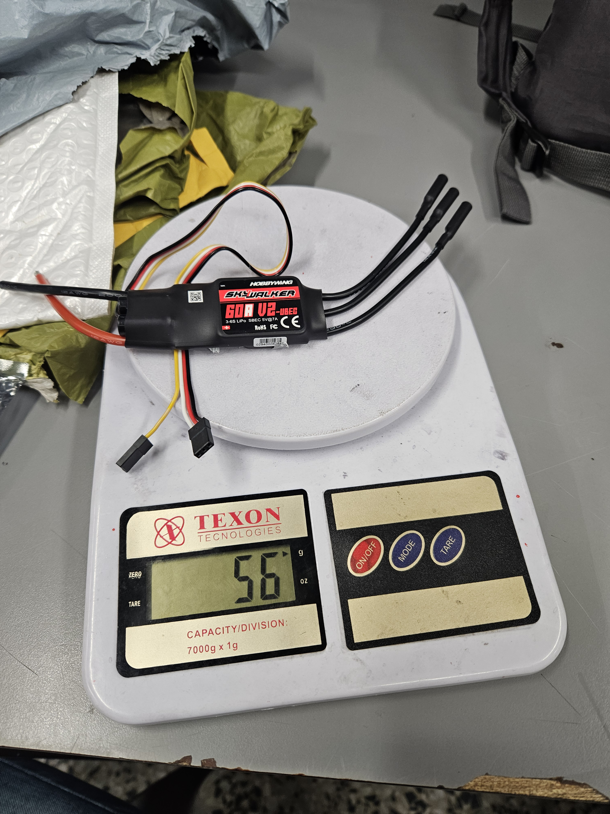
weights/20261016_172121.jpg
