ElJoho/BerkikRe-Design/weights/20261016_172122.jpg

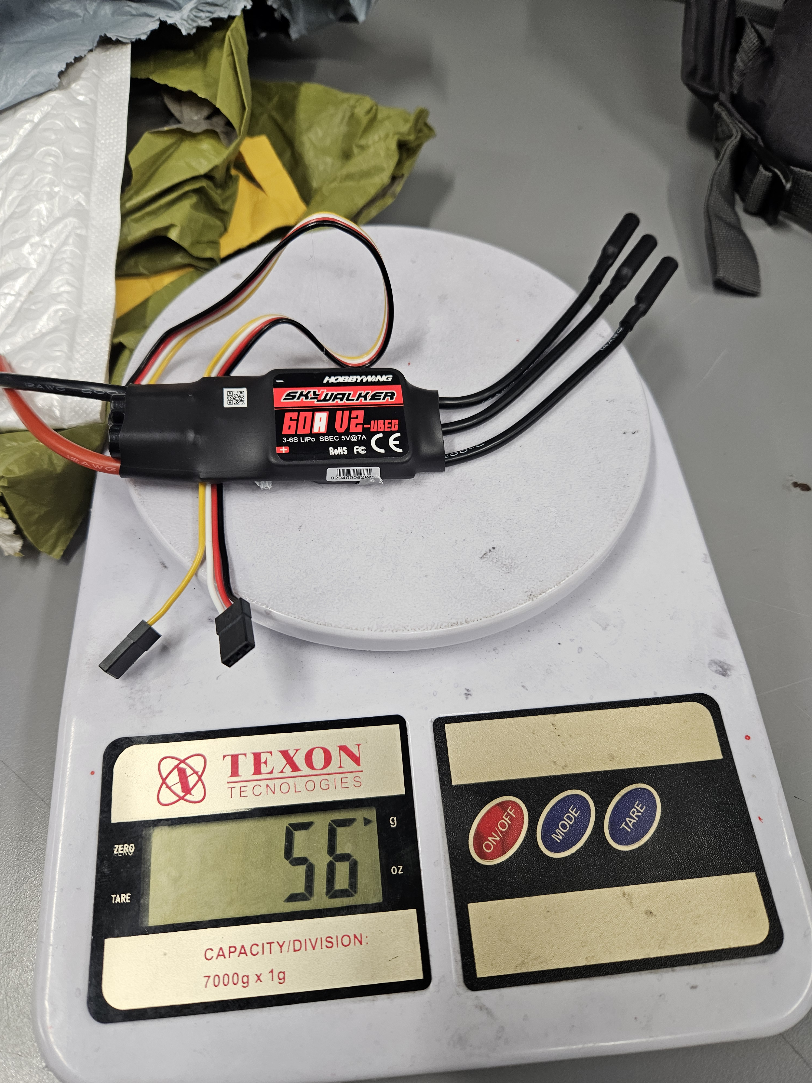
weights/20261016_172122.jpg
