ElJoho/BerkikRe-Design/weights/20261016_172141.jpg

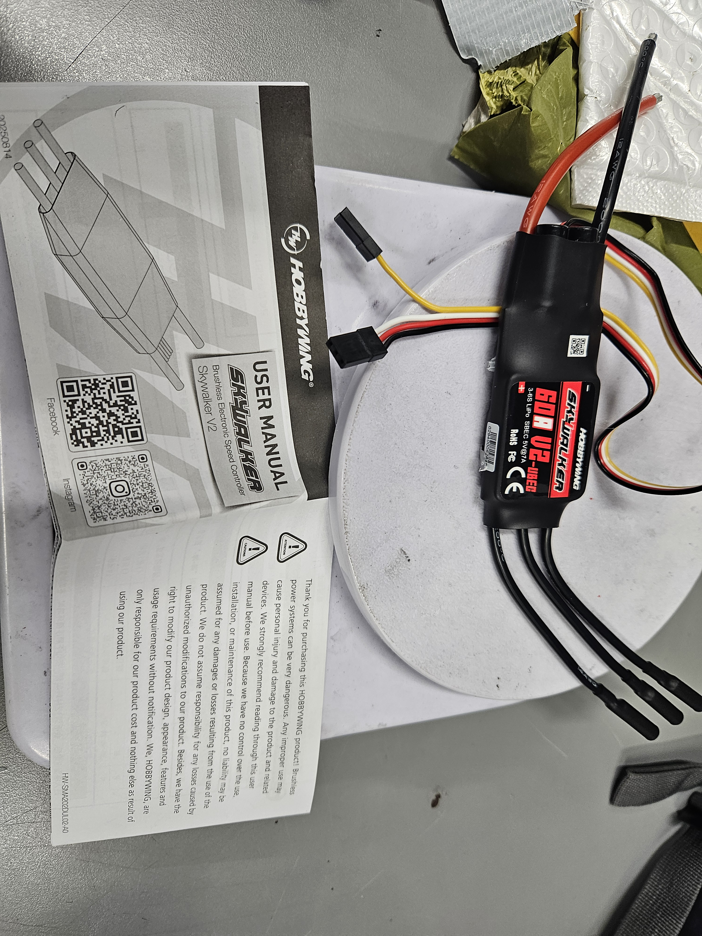
weights/20261016_172141.jpg
