ElJoho/BerkikRe-Design/weights/20261016_172232.jpg

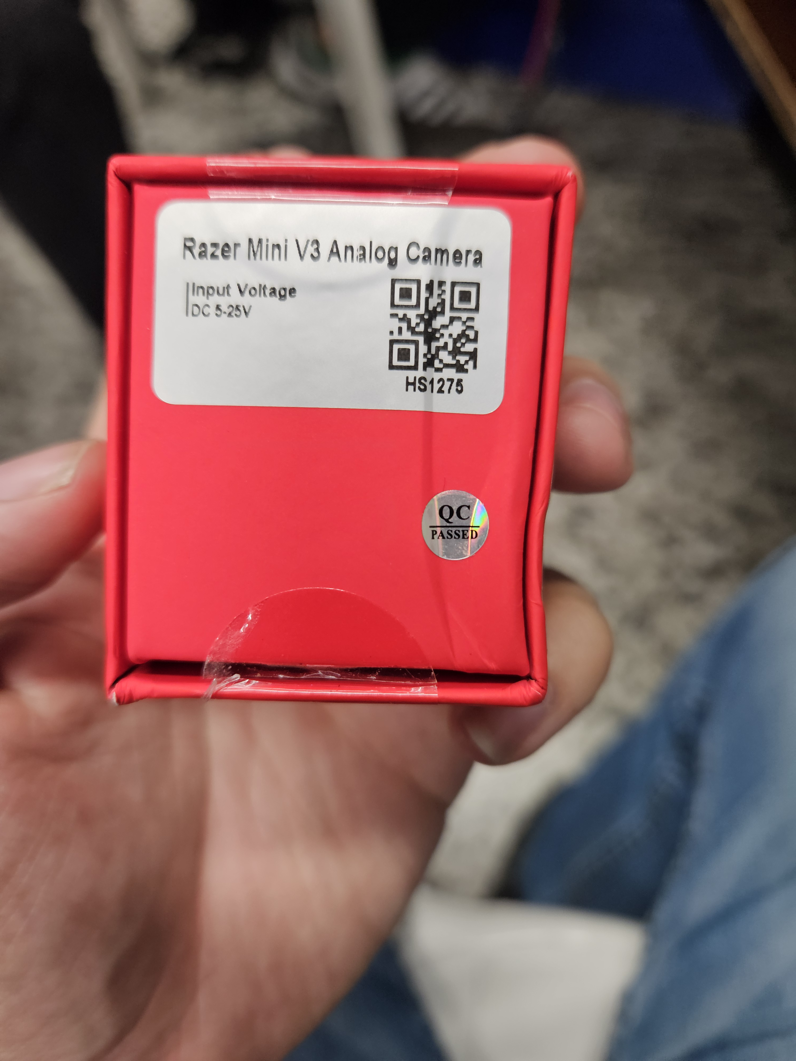
weights/20261016_172232.jpg
