ElJoho/BerkikRe-Design/weights/20261016_172312.jpg

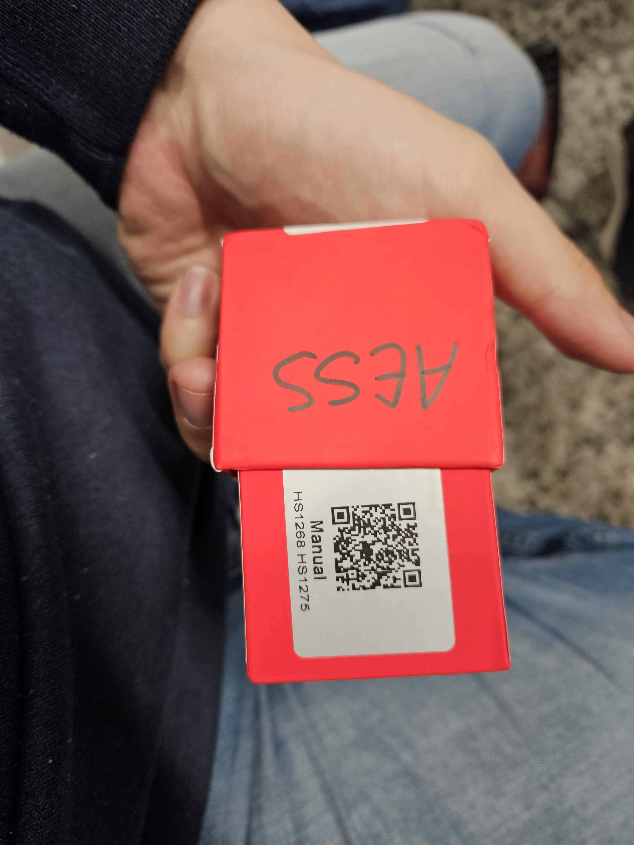
weights/20261016_172312.jpg
