ElJoho/BerkikRe-Design/weights/20261016_172315.jpg

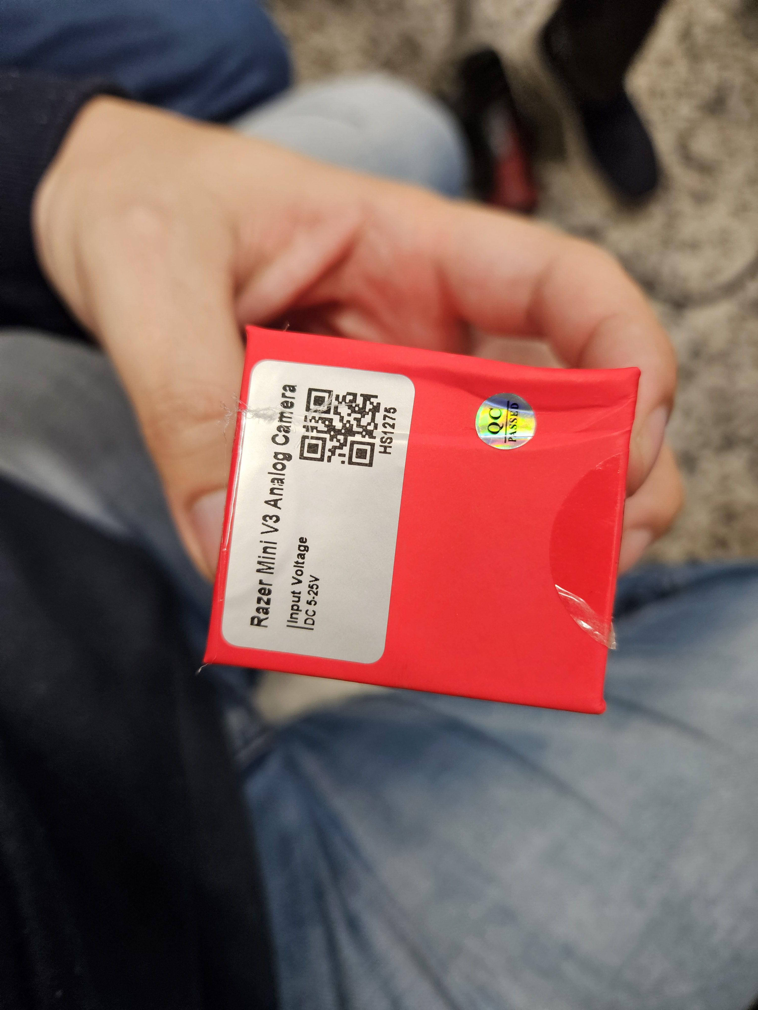
weights/20261016_172315.jpg
