ElJoho/BerkikRe-Design/weights/20261016_172344.jpg

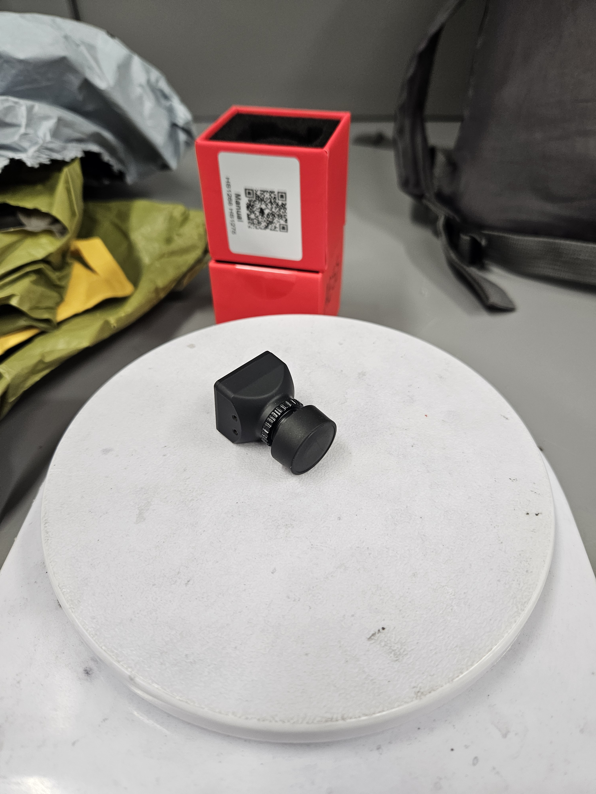
weights/20261016_172344.jpg
