ElJoho/BerkikRe-Design/weights/20261016_172346.jpg

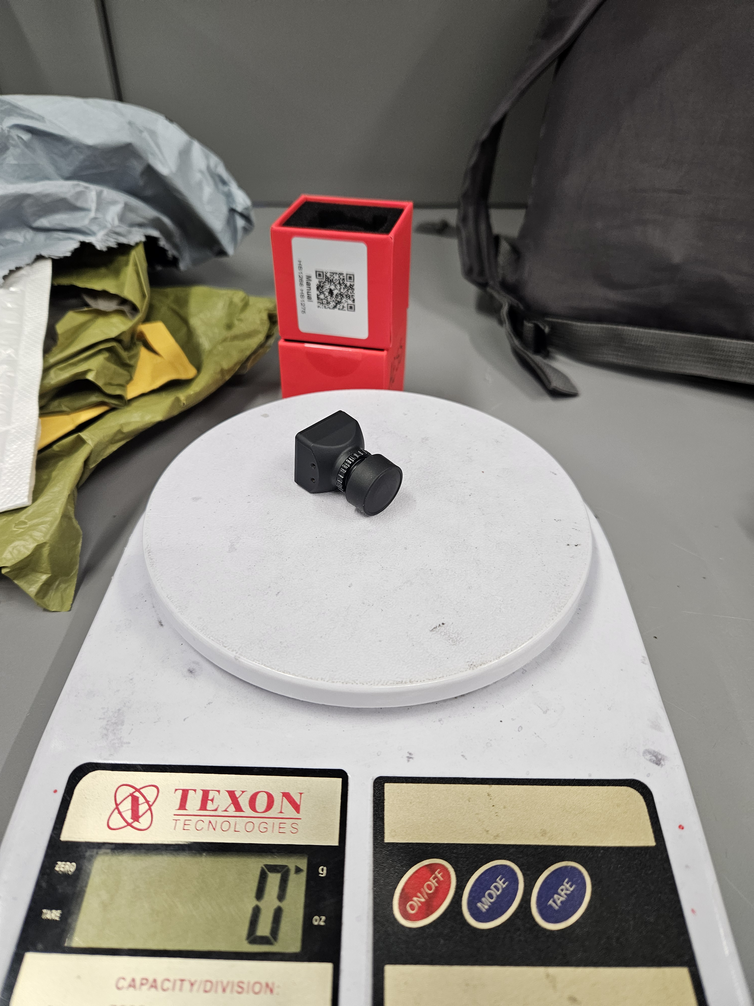
weights/20261016_172346.jpg
