ElJoho/BerkikRe-Design/weights/20261016_172359.jpg

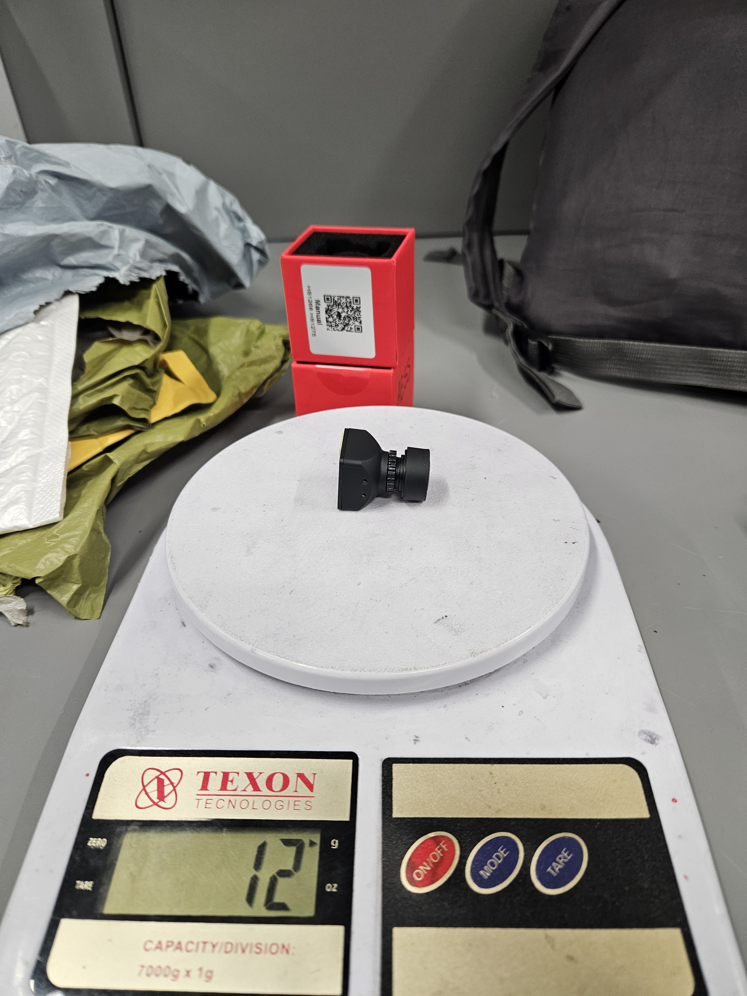
weights/20261016_172359.jpg
