ElJoho/BerkikRe-Design/weights/20261016_172404.jpg

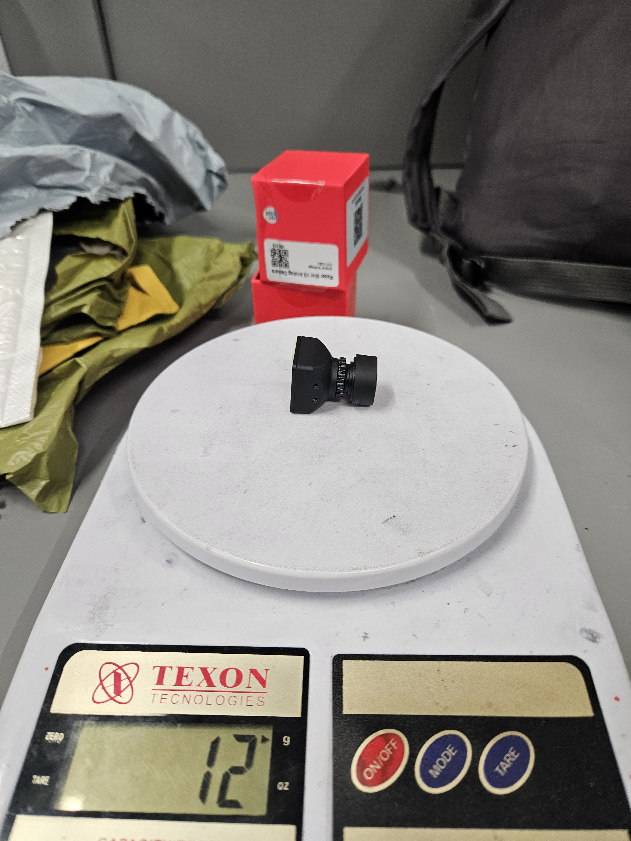
weights/20261016_172404.jpg
