ElJoho/BerkikRe-Design/weights/20261016_172507.jpg

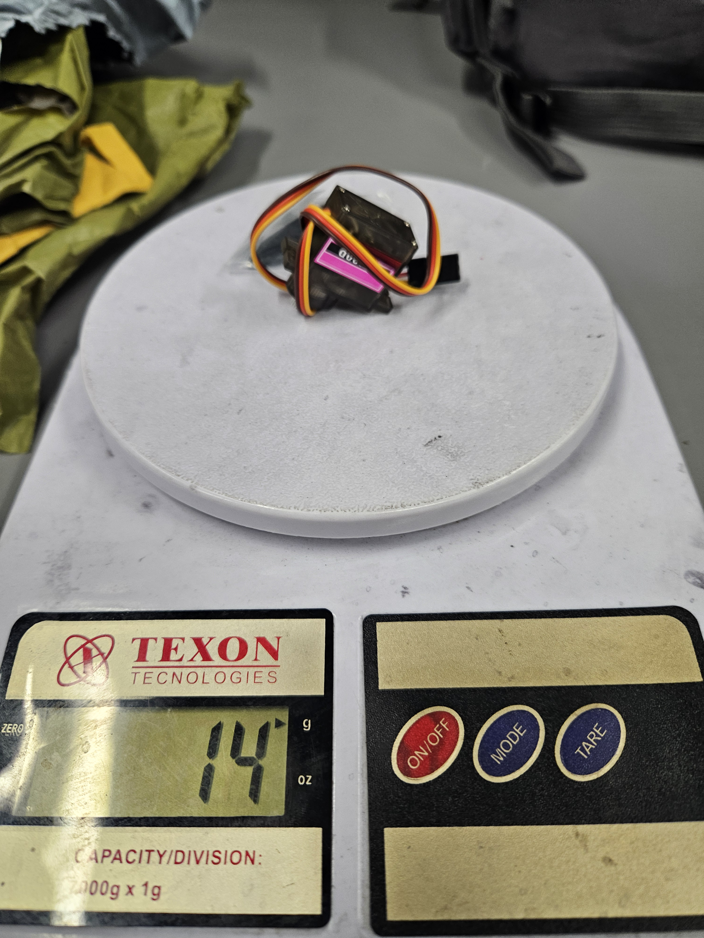
weights/20261016_172507.jpg
