ElJoho/BerkikRe-Design/weights/20261016_172515.jpg

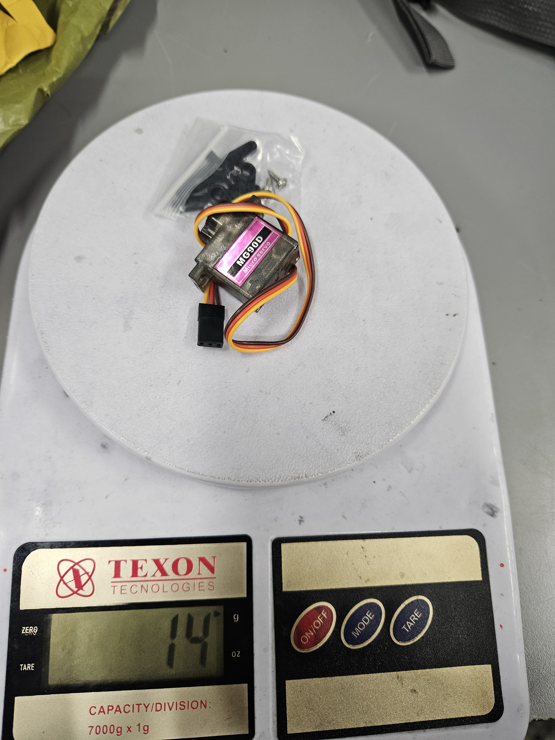
weights/20261016_172515.jpg
