ElJoho/BerkikRe-Design/weights/20261016_172611.jpg

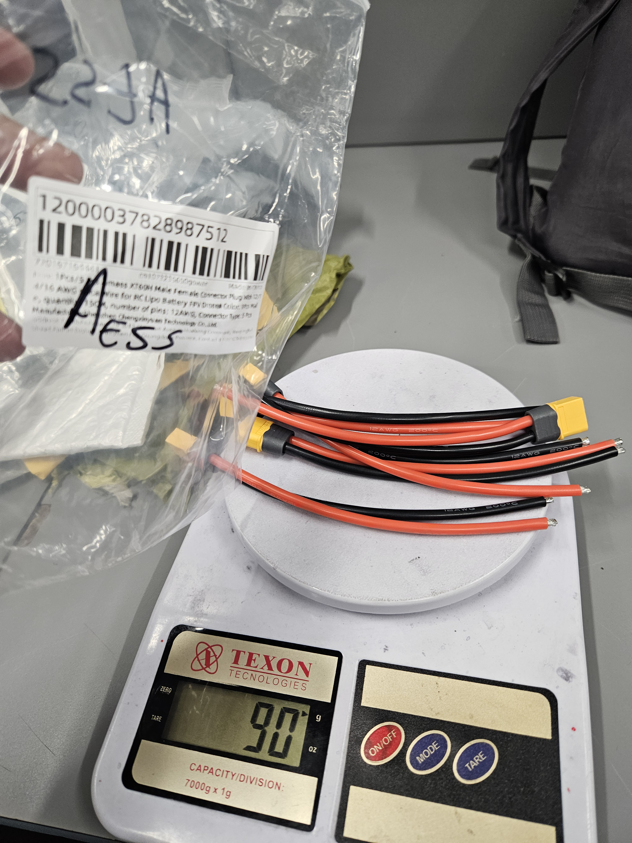
weights/20261016_172611.jpg
