ElJoho/BerkikRe-Design/weights/20261016_172939.jpg

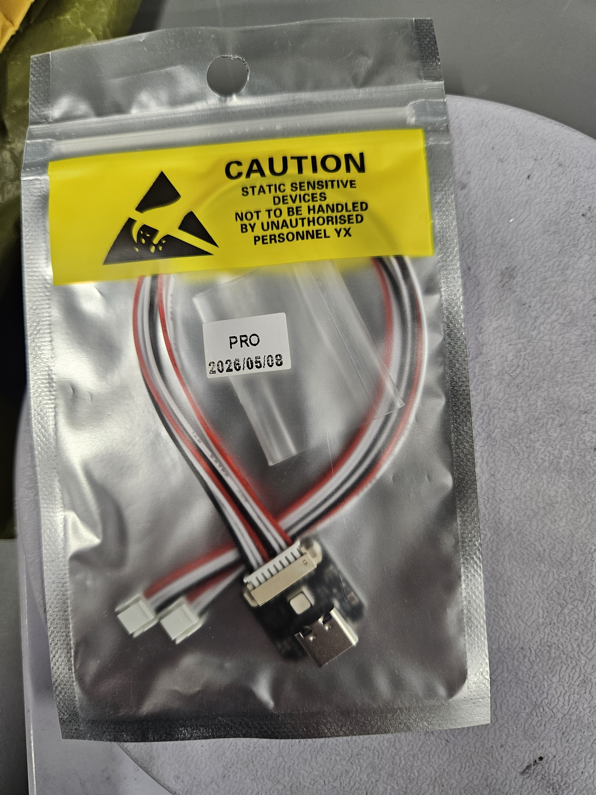
weights/20261016_172939.jpg
