ElJoho/BerkikRe-Design/weights/20261016_172956.jpg

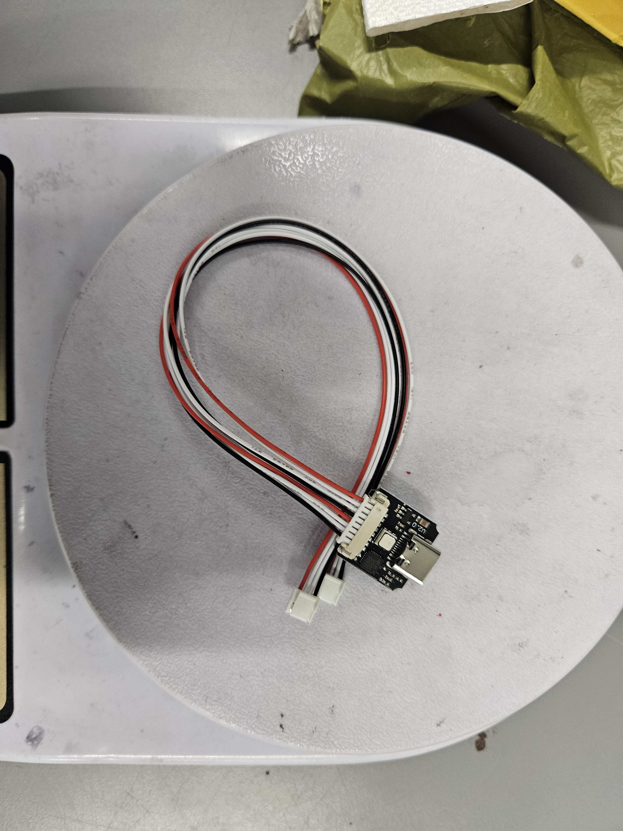
weights/20261016_172956.jpg
