ElJoho/BerkikRe-Design/weights/20261016_173051.jpg

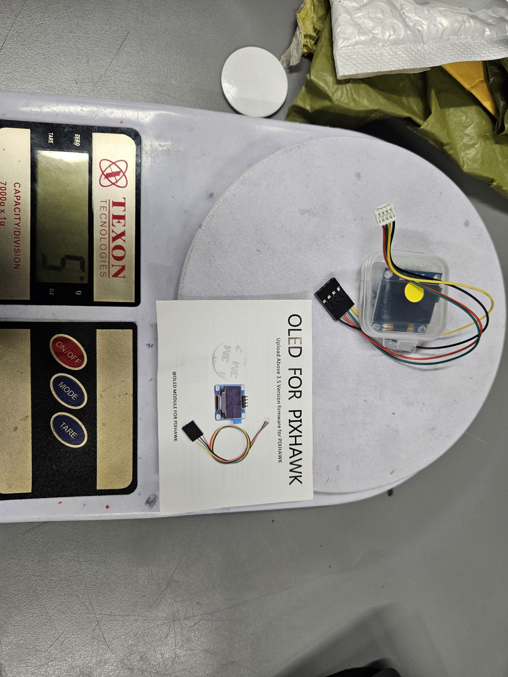
weights/20261016_173051.jpg
