ElJoho/BerkikRe-Design/weights/20261016_173214.jpg

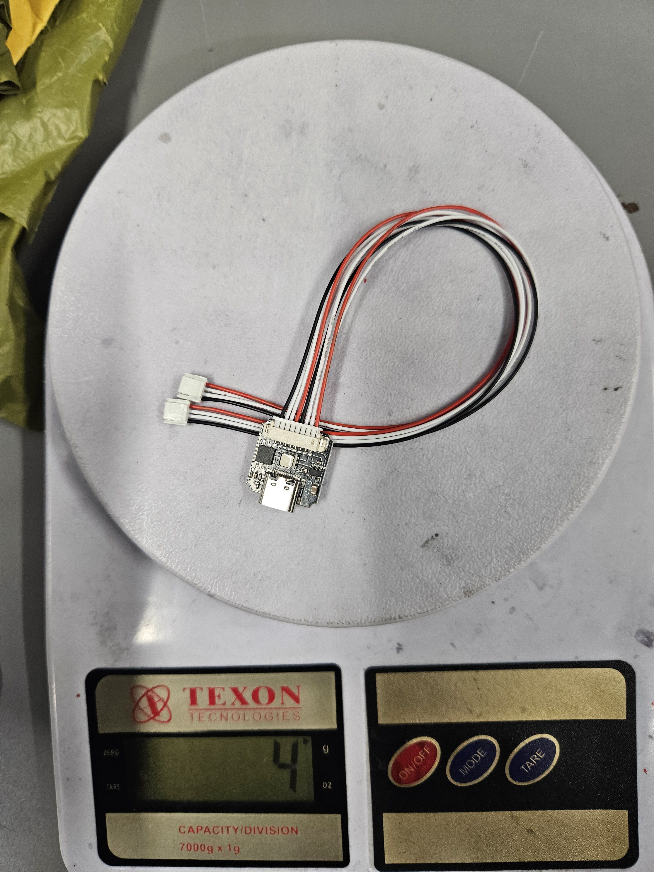
weights/20261016_173214.jpg
