ElJoho/BerkikRe-Design/weights/20261016_173227.jpg

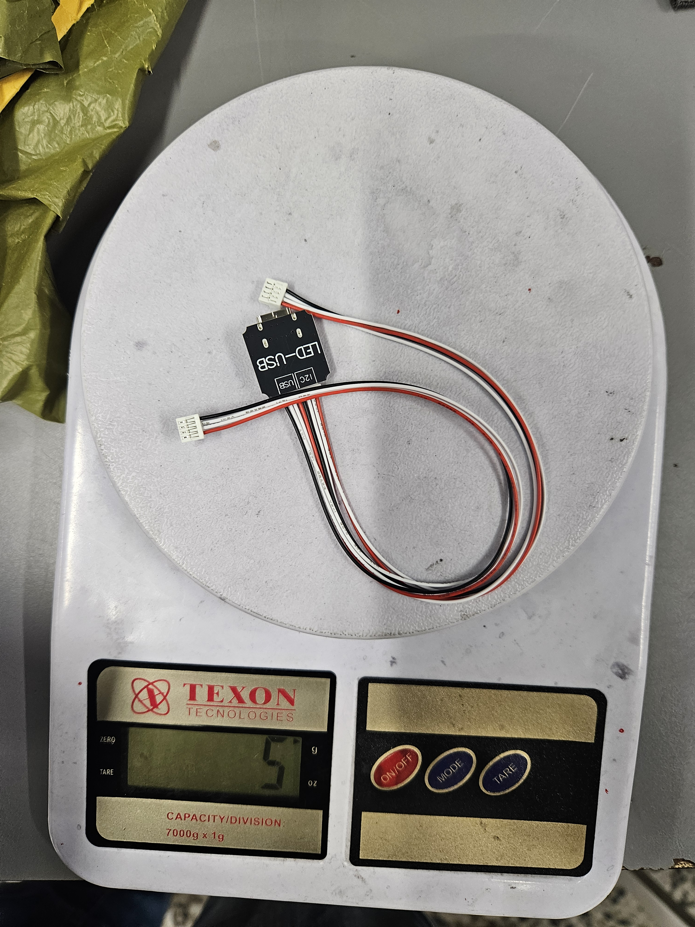
weights/20261016_173227.jpg
