ElJoho/BerkikRe-Design/weights/20261016_173340.jpg

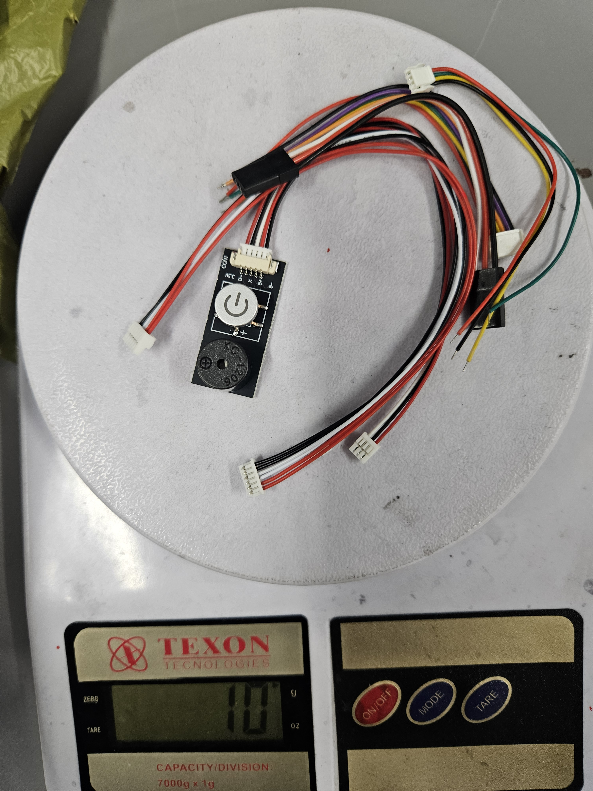
weights/20261016_173340.jpg
