ElJoho/BerkikRe-Design/weights/20261016_173343.jpg

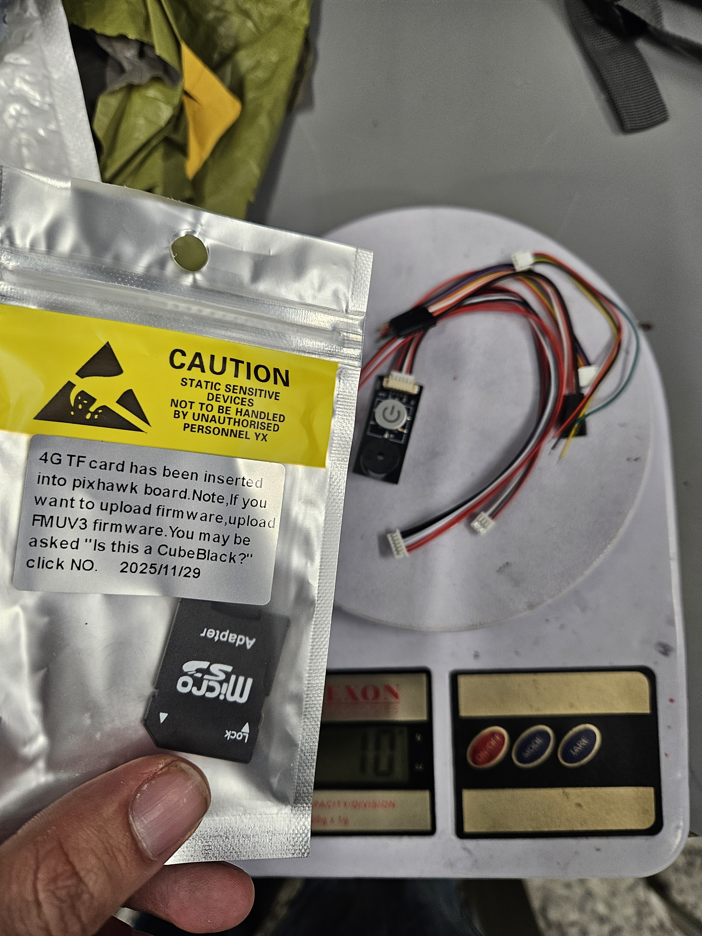
weights/20261016_173343.jpg
