ElJoho/BerkikRe-Design/weights/20261016_173350.jpg

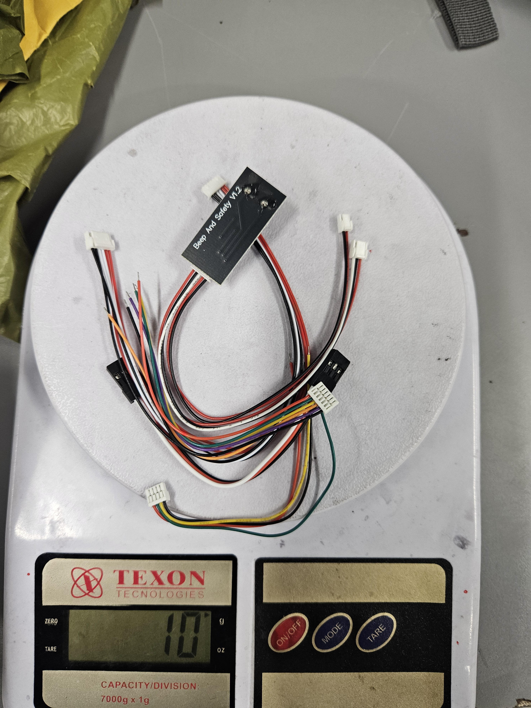
weights/20261016_173350.jpg
