ElJoho/BerkikRe-Design/weights/20261016_173351.jpg

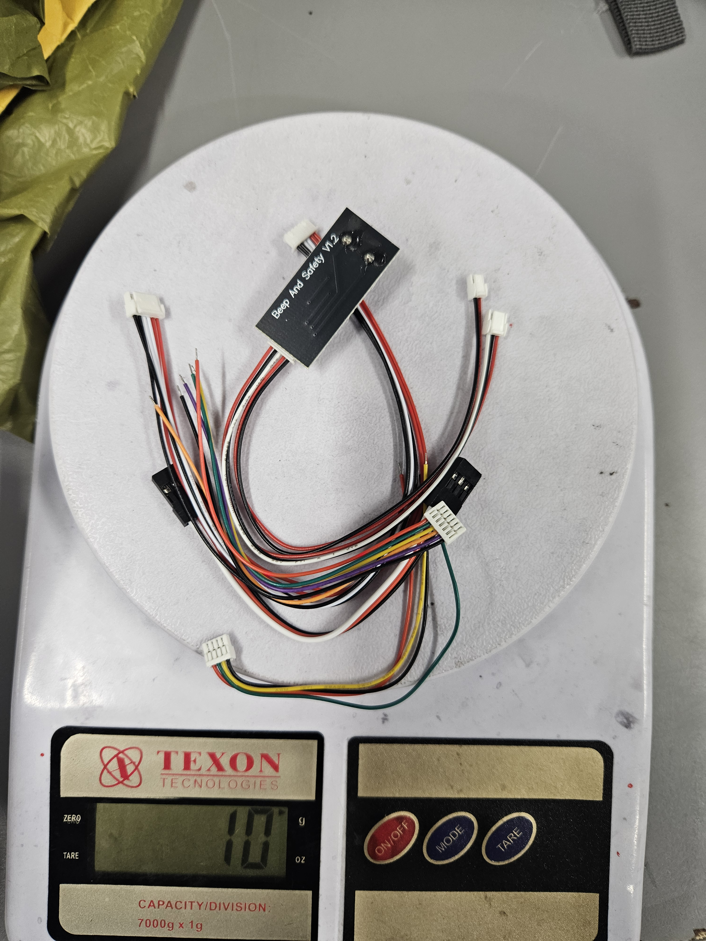
weights/20261016_173351.jpg
