ElJoho/BerkikRe-Design/weights/20261016_173511.jpg

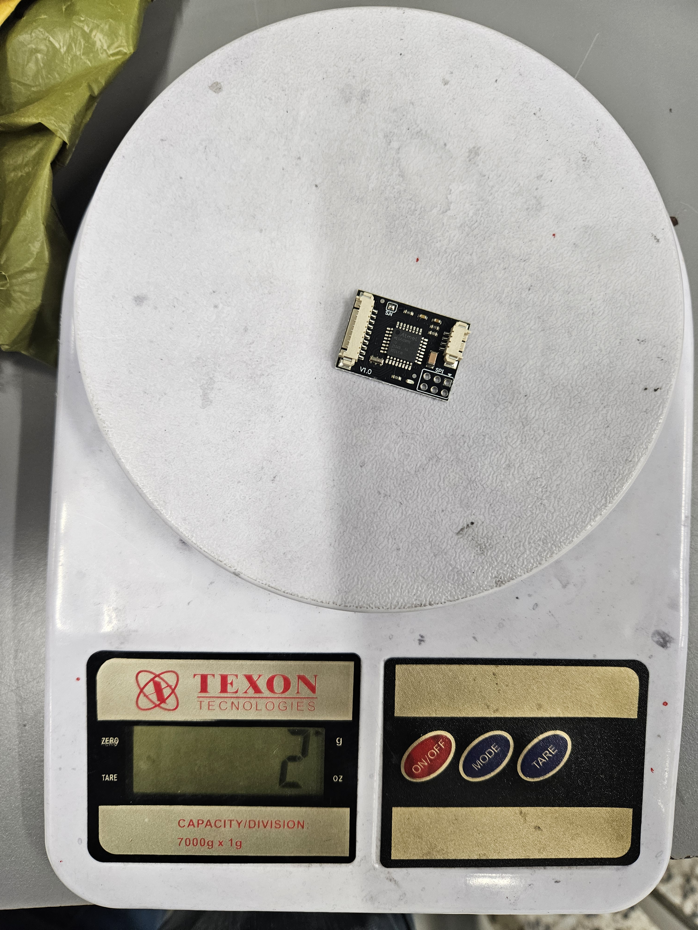
weights/20261016_173511.jpg
