ElJoho/BerkikRe-Design/weights/20261016_173519.jpg

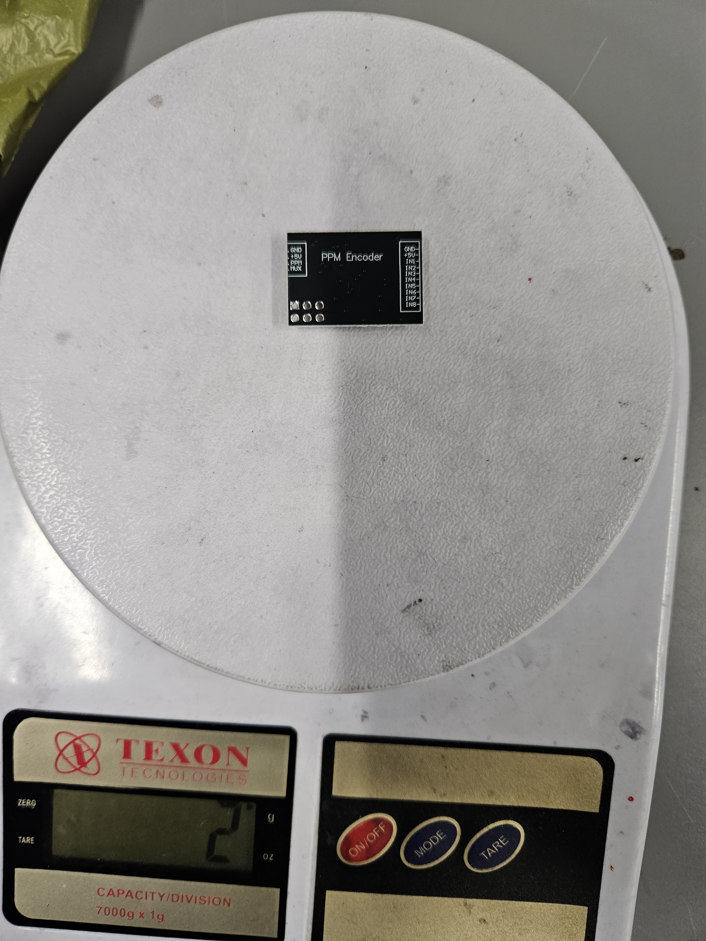
weights/20261016_173519.jpg
