ElJoho/BerkikRe-Design/weights/20261016_173828.jpg

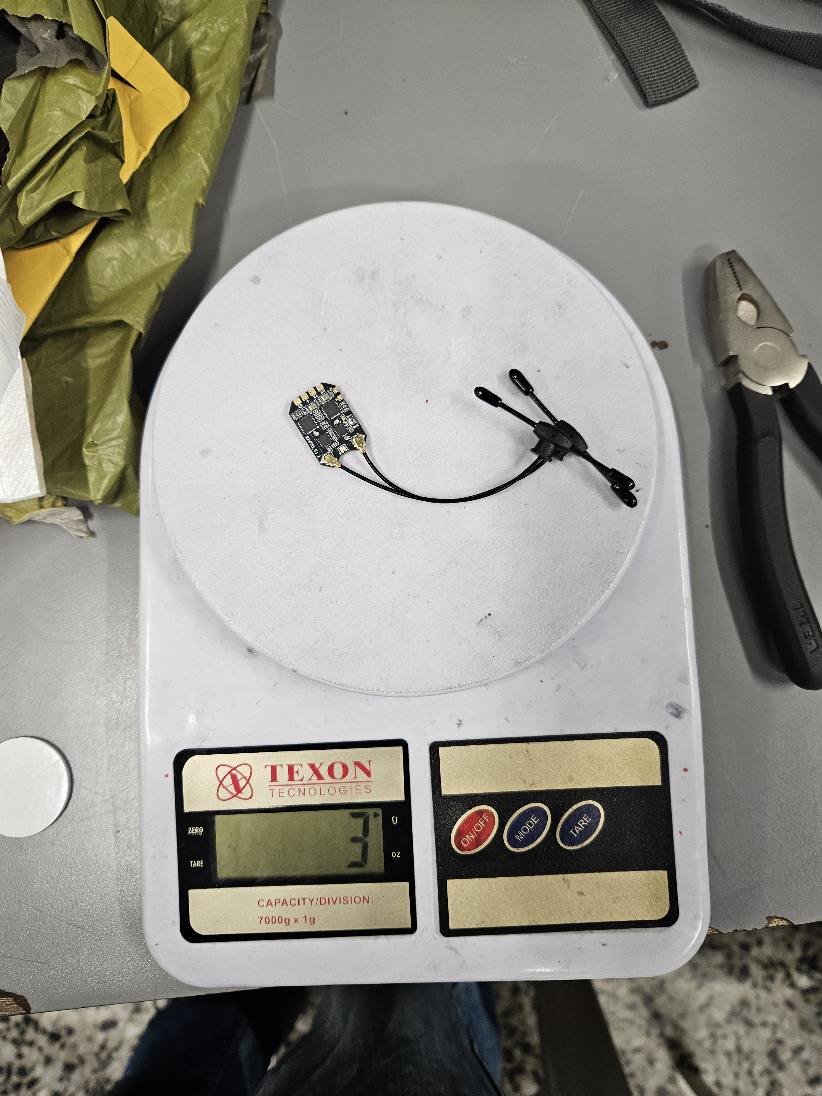
weights/20261016_173828.jpg
