ElJoho/BerkikRe-Design/weights/20261016_173838.jpg

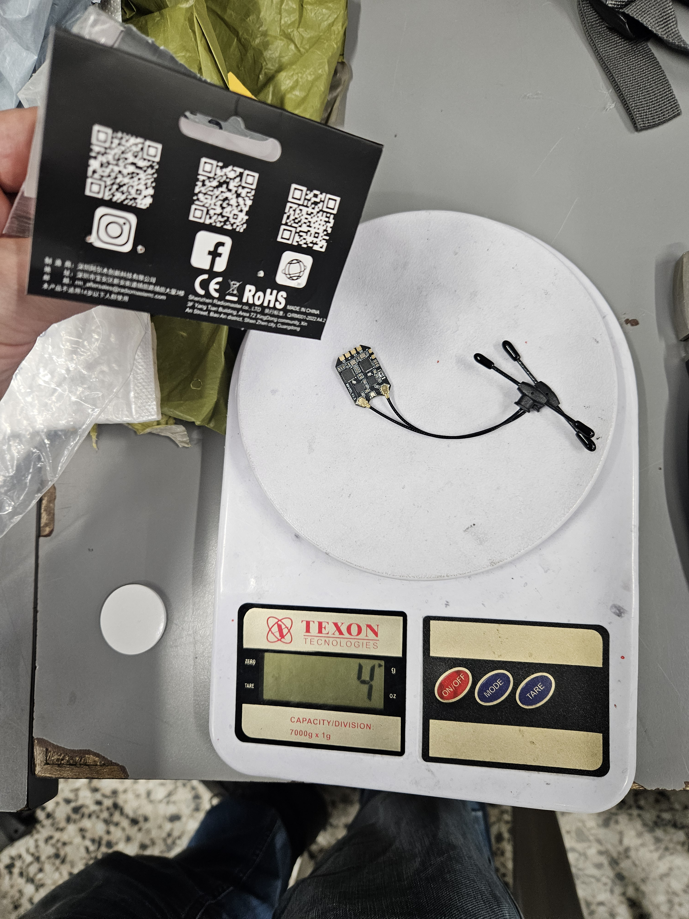
weights/20261016_173838.jpg
