ElJoho/BerkikRe-Design/weights/20261016_173839.jpg

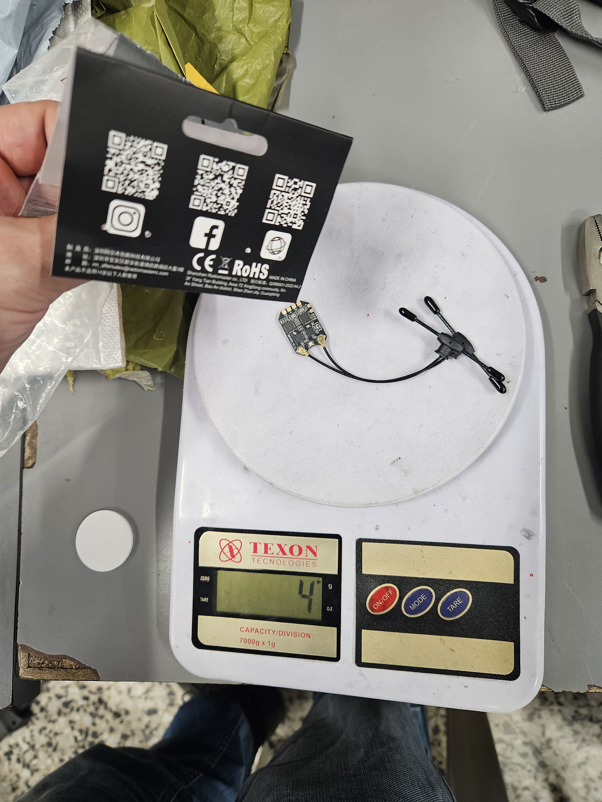
weights/20261016_173839.jpg
