ElJoho/BerkikRe-Design/weights/20261016_173842.jpg

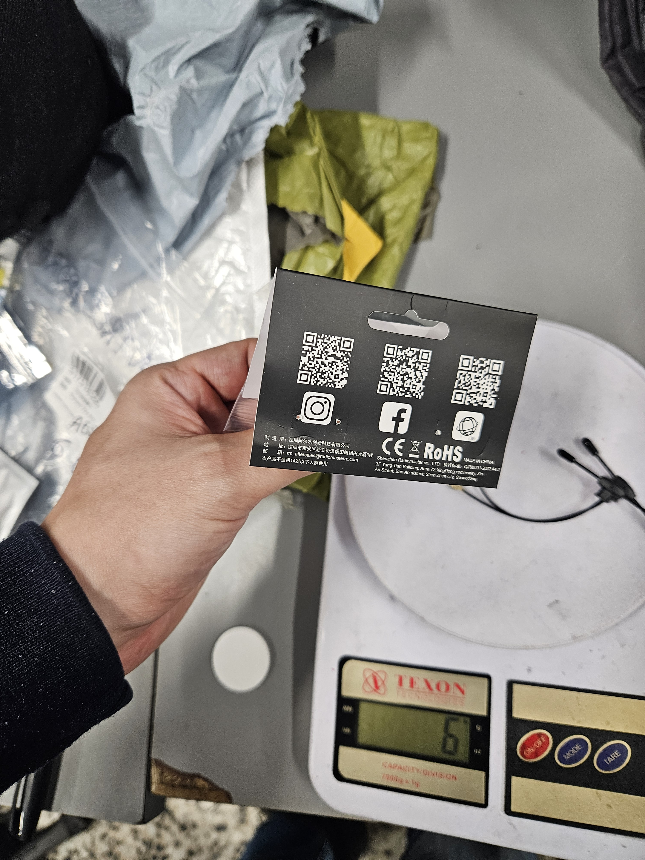
weights/20261016_173842.jpg
