ElJoho/BerkikRe-Design/weights/20261016_173849.jpg

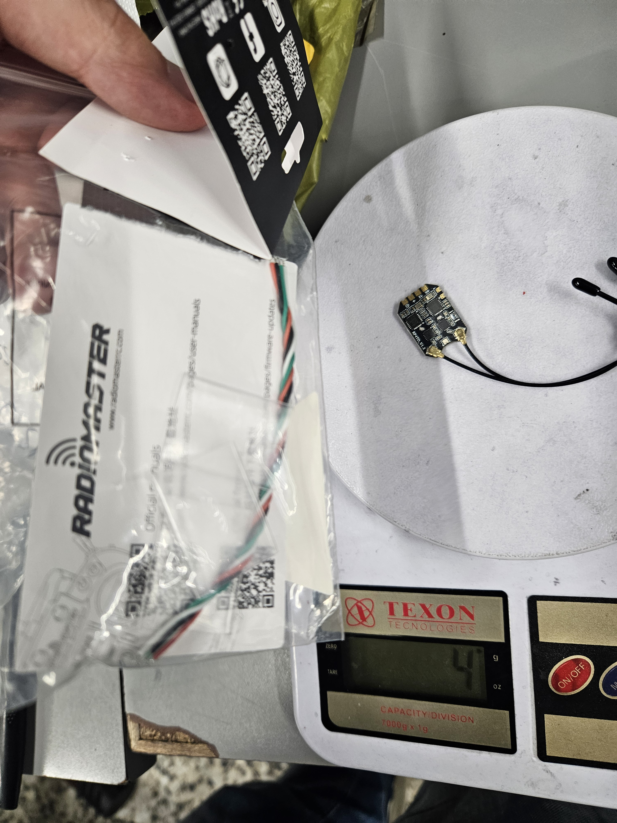
weights/20261016_173849.jpg
