ElJoho/BerkikRe-Design/weights/20261016_173901.jpg

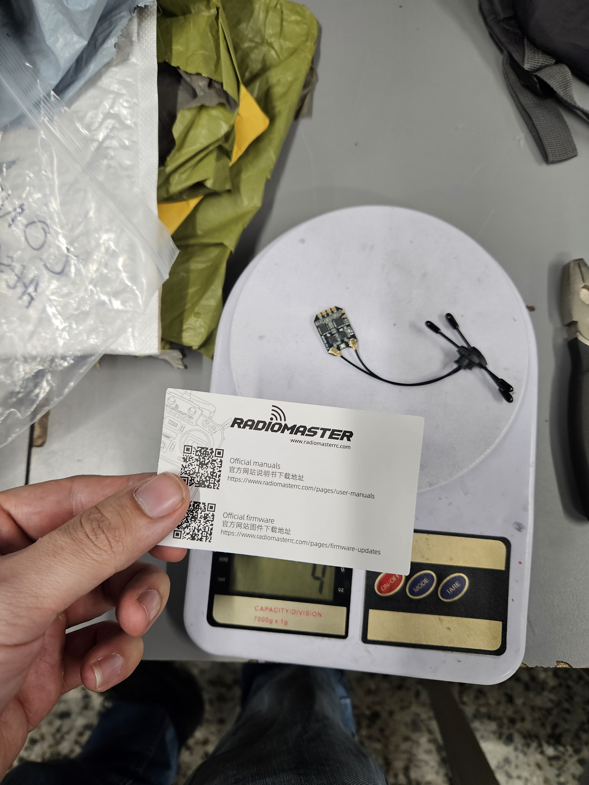
weights/20261016_173901.jpg
