ElJoho/BerkikRe-Design/weights/20261016_174919.jpg

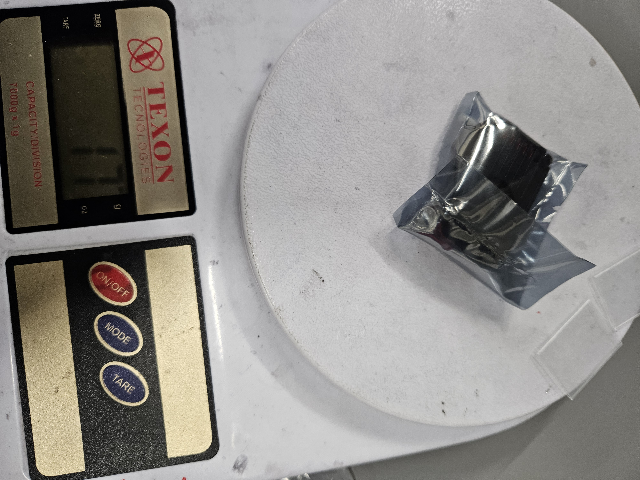
weights/20261016_174919.jpg
