ElJoho/BerkikRe-Design/(list of files, cad)

Other CAD files:
STL/cfd/berkirkSilouteReducedTail.stl
STP/fixed/berkirkSilouteReducedTail.stp
STP/W13.dxf
STL/cfd/berkirkSiloute.stl
STP/fixed/berkirkSilouteChangedWings.stp
STP/W2.dxf
STL/cfd/berkirkSilouteConstantCornersChangedWings.stl
STP/fixed/berkirkSilouteReducedTailChangedWings.stp
STP/W7.dxf
STL/cfd/berkirkSilouteConstantCornersReducedTailChangedWings.stl
STP/fixed/contourn.stp
STP/layout.dwg
STL/cfd/contourn.stl
STP/berkirkSilouteReducedTailChangedWings.stp
STP/fixed/berkirkSilouteConstantCorners.stp
STL/cfd/berkirkSilouteConstantCornersReducedTail.stl
STP/berkirkSilouteChangedWings.stp
STP/fixed/berkirkSiloute.stp
STL/cfd/berkirkSilouteChangedWings.stl
STP/berkirkSilouteConstantCornersReducedTailChangedWings.stp
STP/fixed/berkirkSilouteConstantCornersReducedTailChangedWings.stp
STL/cfd/berkirkSilouteReducedTailChangedWings.stl
STP/berkirkSilouteReducedTail.stp
STP/fixed/berkirkSilouteConstantCornersReducedTail.stp
STL/cfd/berkirkSilouteConstantCorners.stl
STP/berkirkSilouteConstantCorners.stp
STP/fixed/berkirkSilouteConstantCornersChangedWings.stp
STP/berkirkSilouteConstantCornersChangedWings.stp
STP/berkirkSilouteConstantCornersReducedTail.stp
STP/contourn.stp
STP/berkirkSiloute.stp
CAD/OldVersions/berkirkSiloute.0010.ipt
CAD/OldVersions/berkirkSiloute.0018.ipt
CAD/OldVersions/berkirkSiloute.0022.ipt
CAD/OldVersions/berkirkSilouteChangedWings.0006.ipt
CAD/OldVersions/berkirkSilouteChangedWings.0010.ipt
CAD/OldVersions/berkirkSilouteChangedWings.0014.ipt
CAD/OldVersions/berkirkSilouteConstantCorners.0005.ipt
CAD/OldVersions/berkirkSilouteConstantCorners.0008.ipt
CAD/OldVersions/berkirkSilouteConstantCorners.0012.ipt
CAD/OldVersions/berkirkSilouteConstantCornersChangedWings.0004.ipt
CAD/OldVersions/berkirkSilouteConstantCornersChangedWings.0007.ipt
CAD/OldVersions/berkirkSilouteConstantCornersChangedWings.0011.ipt
CAD/OldVersions/berkirkSilouteConstantCornersReducedTail.0002.ipt
CAD/OldVersions/berkirkSilouteConstantCornersReducedTail.0006.ipt
CAD/OldVersions/berkirkSilouteConstantCornersReducedTail.0011.ipt
CAD/OldVersions/berkirkSilouteConstantCornersReducedTailChangedWings.0005.ipt
CAD/OldVersions/berkirkSilouteConstantCornersReducedTailChangedWings.0009.ipt
CAD/OldVersions/berkirkSilouteConstantCornersReducedTailChangedWings.0012.ipt
CAD/OldVersions/berkirkSilouteConstantCornersReducedTailChangedWings.0014.ipt
CAD/OldVersions/berkirkSilouteReducedTail.0002.ipt
CAD/OldVersions/berkirkSilouteReducedTail.0005.ipt
CAD/OldVersions/berkirkSilouteReducedTail.0008.ipt
CAD/OldVersions/berkirkSilouteReducedTailChangedWings.0002.ipt
CAD/OldVersions/berkirkSilouteReducedTailChangedWings.0005.ipt
CAD/OldVersions/berkirkSilouteReducedTailChangedWings.0008.ipt
CAD/OldVersions/contourn.0014.ipt
CAD/OldVersions/contourn.0020.ipt
CAD/OldVersions/contourn.0024.ipt
CAD/berkirkSiloute.ipt
CAD/berkirkSilouteChangedWings.ipt
CAD/berkirkSilouteConstantCorners.ipt
CAD/berkirkSilouteConstantCornersChangedWings.ipt
CAD/berkirkSilouteConstantCornersReducedTail.ipt
CAD/berkirkSilouteConstantCornersReducedTailChangedWings.ipt
CAD/berkirkSilouteReducedTail.ipt
CAD/berkirkSilouteReducedTailChangedWings.ipt
CAD/contourn.ipt
STL/berkirkSiloute.stl
STL/berkirkSilouteChangedWings.stl
STL/berkirkSilouteConstantCorners.stl
STL/berkirkSilouteConstantCornersChangedWings.stl
STL/berkirkSilouteConstantCornersReducedTail.stl
STL/berkirkSilouteConstantCornersReducedTailChangedWings.stl
STL/berkirkSilouteReducedTail.stl
STL/berkirkSilouteReducedTailChangedWings.stl
STL/contourn.stl
