ElJoho/BerkikRe-Design/STP/layout.pdf

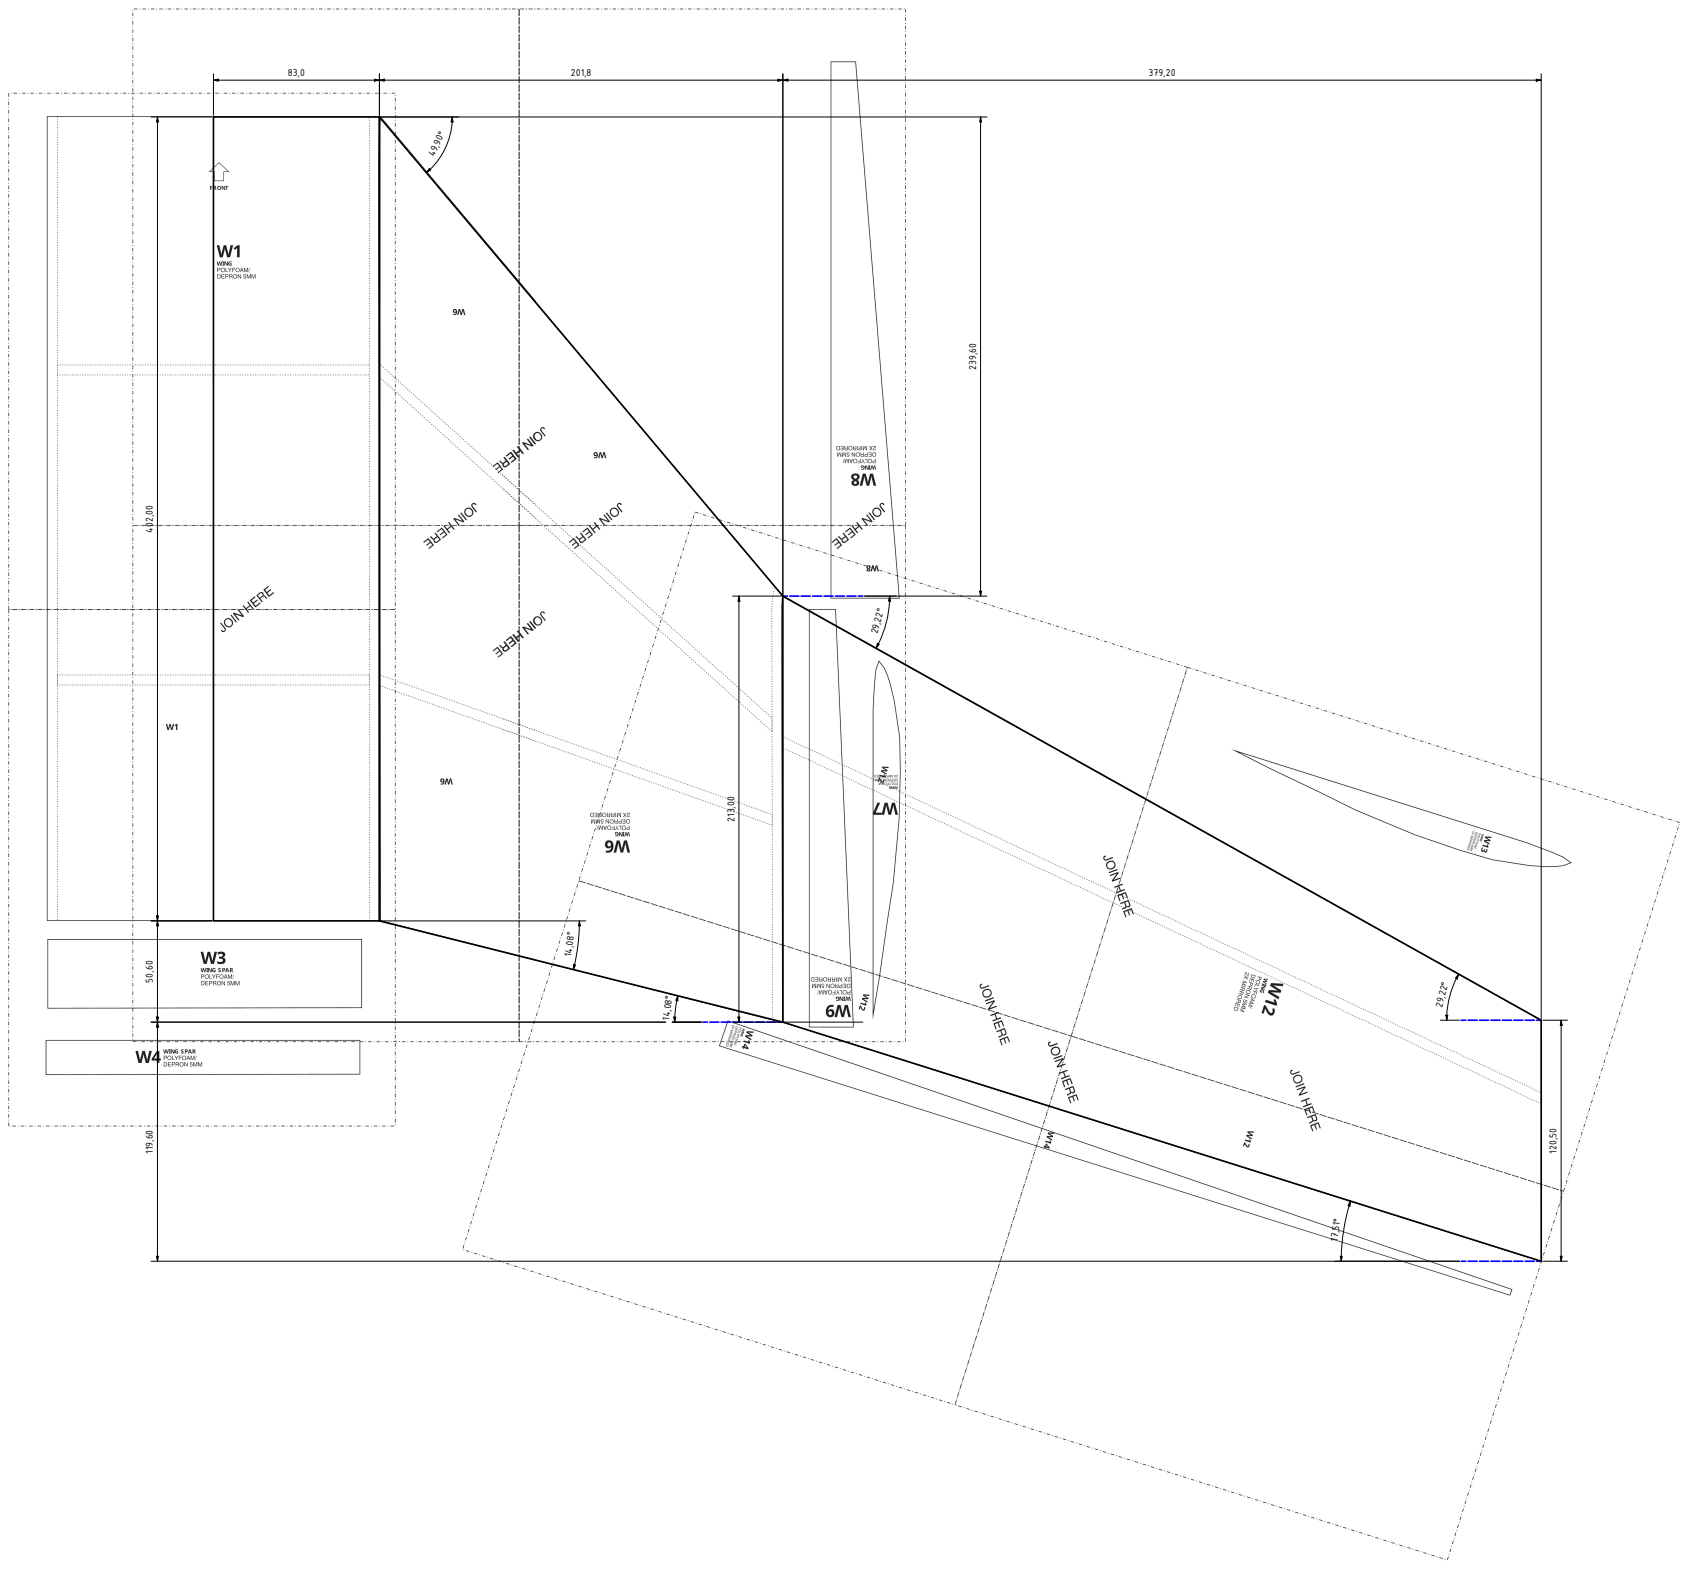
[picture p79: page 1]
