ElJoho/BerkikRe-Design/STP/llayout.pdf

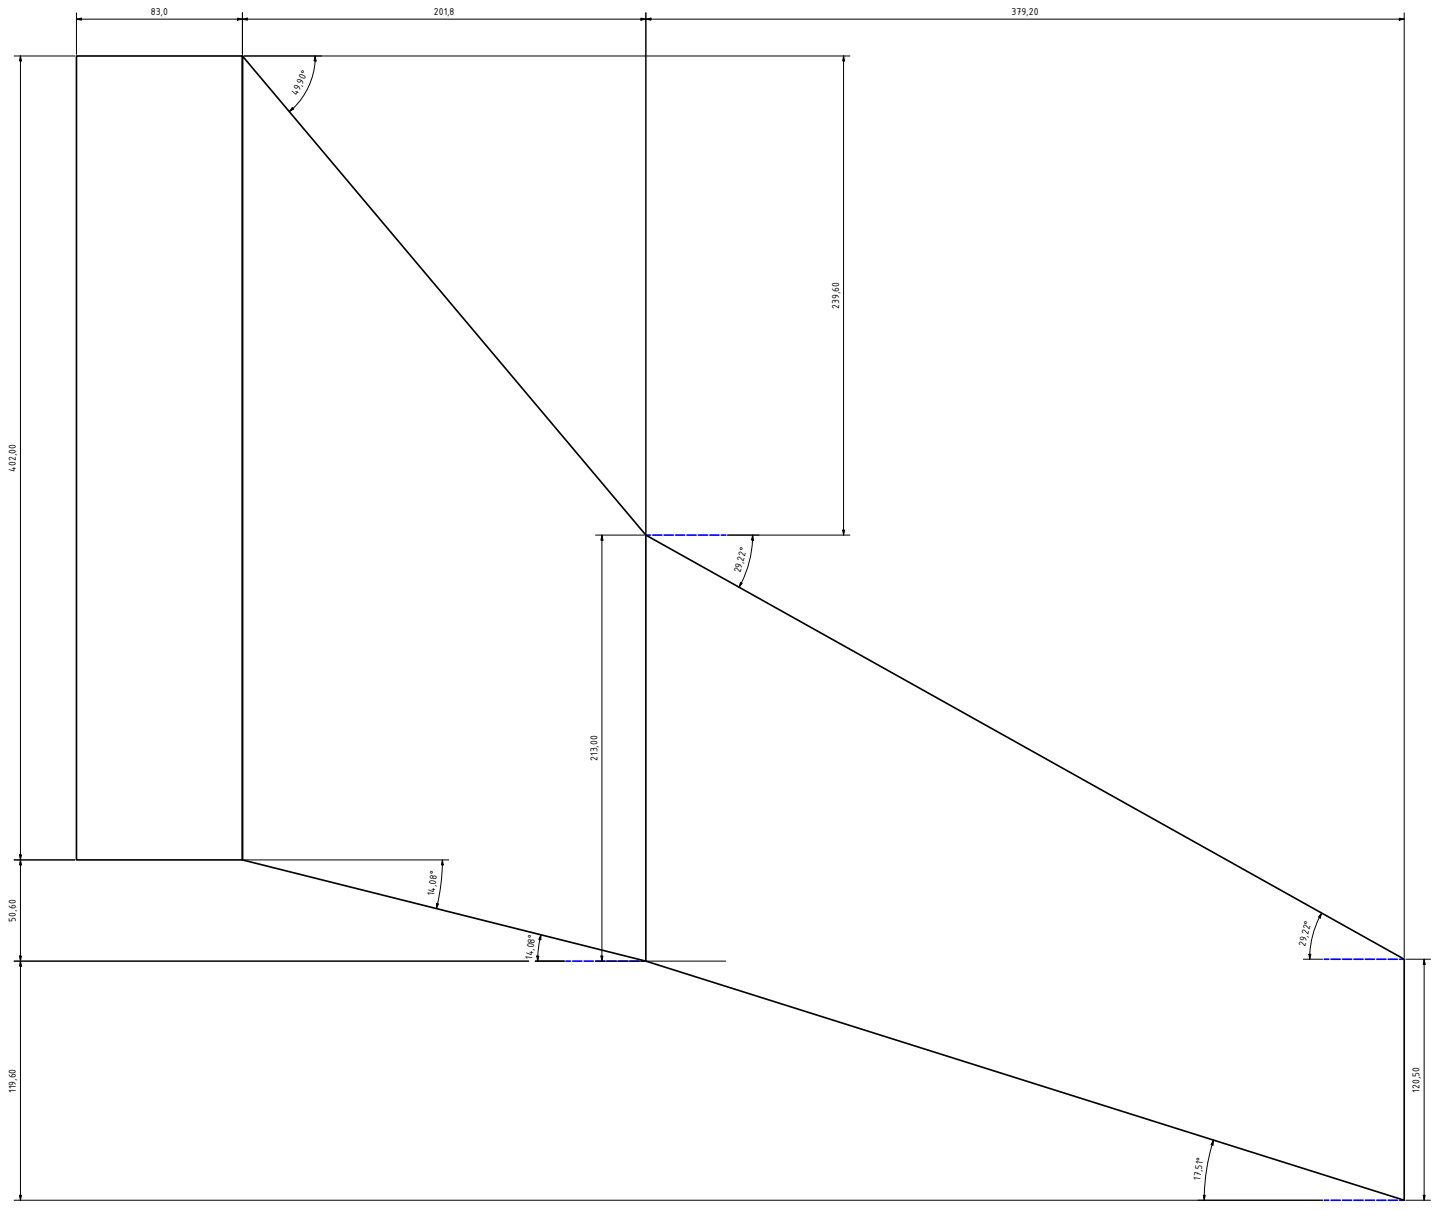
[picture p80: page 1]
