ElJoho/BerkikRe-Design/(commit log)

2026-10-14 Se añadieron todos los CADs, STL e imagenes que se tienen de berkik. Tambien se añadio del gitignore y el gitattributes
2026-10-15 Se añadieron los alerones, se actualizaron los STL y se agregaron los STP
2026-10-15 Se añadieron analisis sobre los STP, estan mal, hay que arreglar el aleron
2026-10-15 Se repararon y alinearon los STP y se generaron STL finos para CFD
    - Elevones verificados: un solo cuerpo en los 9 modelos; los 9 STL limpios
    (contourn y Base re-exportados bien). STP de CC y contourn validos.
    - Base, CW, RT y RT+CW: una cara invalida en la superficie superior interna
    del ala (no el aleron); reparada por script con fix() (<1.1 cm3).
    - STP/fixed/: los 9 STP reparados y en el datum comun (origen en la nariz,
    X hacia atras, Y envergadura, Z arriba, mm; CC centrados, sin el offset de 5 mm).
    - STL/cfd/: STL finos y cerrados (0.02 mm, 290k-450k triangulos) para OpenFOAM.
    - Nuevos scripts: step_check.py, step_fix_align.py, stl
    - AERO_REPORT.md: secciones 4.7 y 4.8, Paso 1 act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
2026-10-16 Se hizo el Paso 3: estabilidad, trimado y arrastre con AVL y XFoil
    - Nuevos scripts: extract_sections.py (cortes de los STP alineados),
    avl_build.py (modelos AVL y trimado), xfoil_polars.py (polares y
    correccion viscosa), drag_estimate.py (arrastre y L/D) y
    step3_figures.py (figuras).
    - analysis/avl/: modelos AVL de las 9 variantes, perfiles, polares y
    resultados.
    - analysis/figures/step3_*.png: planta, estabilidad, trimado y arrastre.
    - Masas provisionales: 700 g, CG a 260 mm de la nariz.
    - Punto neutro ~278 mm (familia Base) y ~274.5 mm (familia CC); todas
    necesitan 4-5 grados de elevon arriba para trimar a 12 m/s.
    - AERO_REPORT.md: secciones 4.9 (resultados y figuras) y 4.10 (li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
2026-10-16 Se arreglaron los alerones y se re-exportaron los stl y stp
2026-10-21 Se añadieron las fotos de pesos de los componentes y su tabla de masas
    - weights/: 39 fotos de los componentes en la báscula y components.md con la tabla (componente, referencia, URL, peso, fotos) y lo que no se pudo identificar
    - AERO_REPORT.md: nueva sección §4.11 con la misma tabla y actualización del estado
2026-10-23 Se añadió la conclusión sobre la tendencia a picar con los elevones en 0°
    - Nueva sección §9 "Conclusions" al final de AERO_REPORT.md, con la 9.1:
    con los elevones en 0° las 9 variantes tienden a picar (Cm0 < 0), de
    forma estable, y necesitan elevón arriba para volar nivelado (4-5° visc.,
    10-12° no visc. a 12 m/s). La causa es el elevón al ras del fondo plano.
    - Se actualizaron la fecha y la línea de estado del encabezado.
2026-10-29 Se añadio el layout del ala en el archivo /CB_Cranked_Wing _Edges.ntop que es un custom block
2026-10-30 Se añadieron el custom block de airfold. Lo siguiente es hacer el paso 3 de parametrizacion
