ElJoho/BerkikRe-Design/weights/20261016_172554.jpg

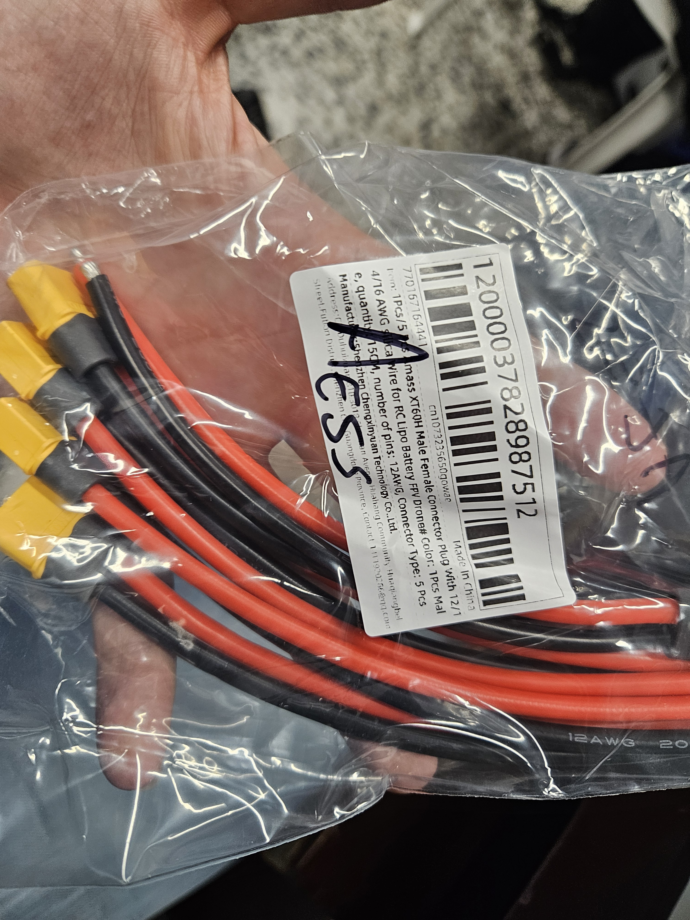
weights/20261016_172554.jpg
