ElJoho/BerkikRe-Design/weights/20261016_172606.jpg

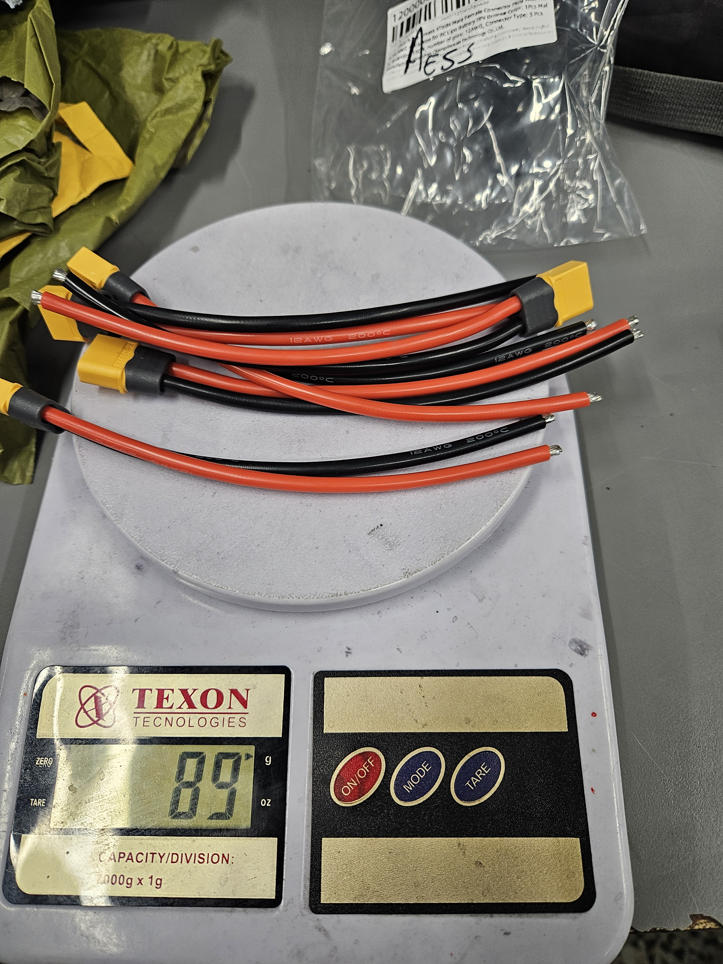
weights/20261016_172606.jpg
