ElJoho/BerkikRe-Design/weights/20261016_172643.jpg

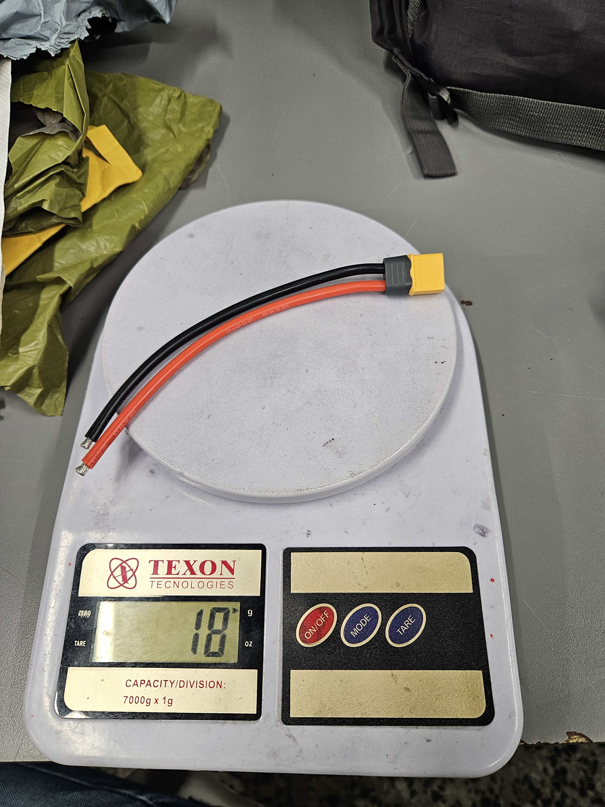
weights/20261016_172643.jpg
