ElJoho/BerkikRe-Design/weights/20261016_174934.jpg

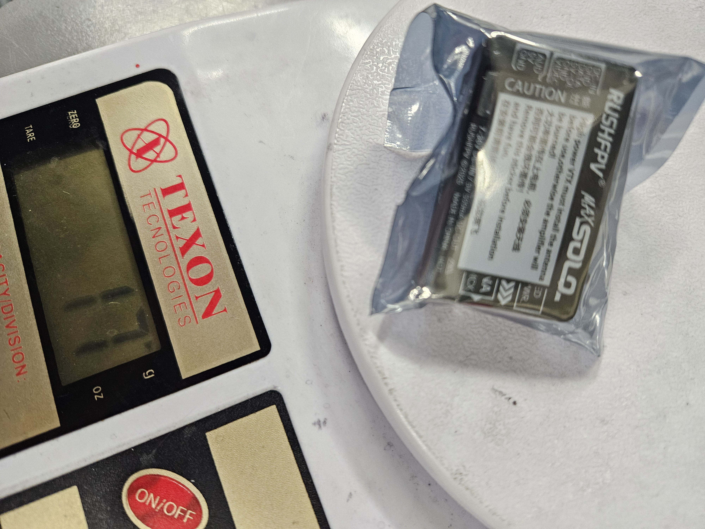
weights/20261016_174934.jpg
