ElJoho/BerkikRe-Design/weights/20261016_175429.jpg

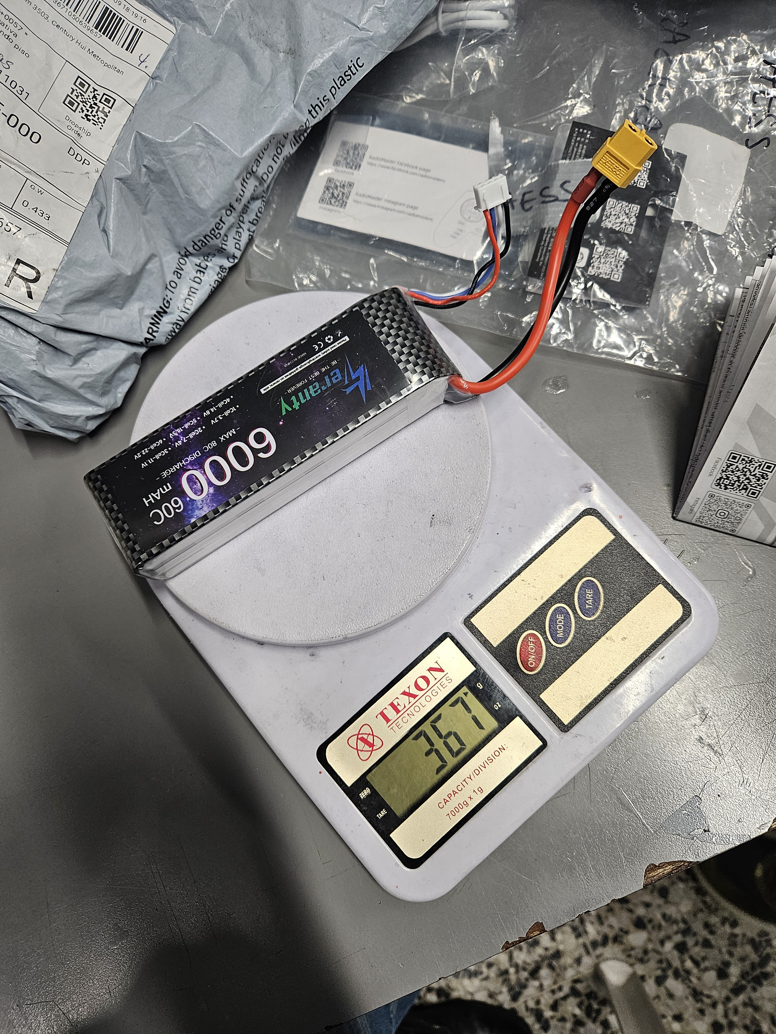
weights/20261016_175429.jpg
